hvitis/Alfa/.github/social-preview.png

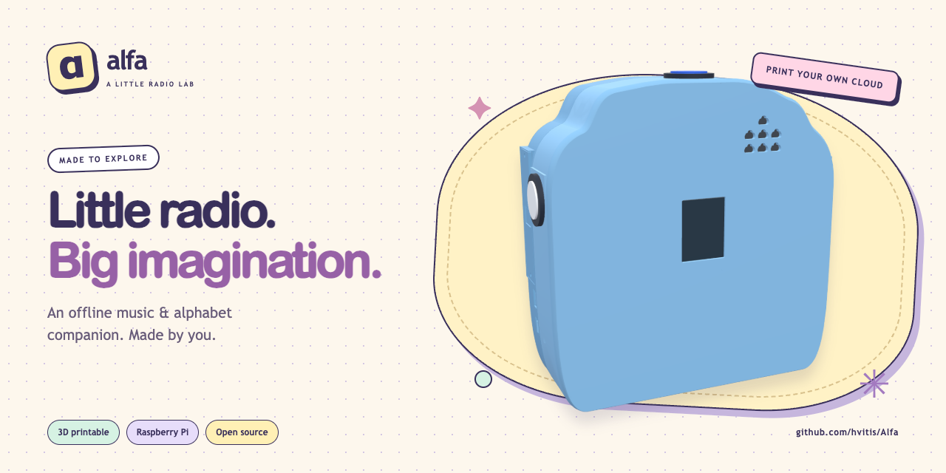
.github/social-preview.png
