hvitis/Alfa/assets/alphabet/01-Ą.png

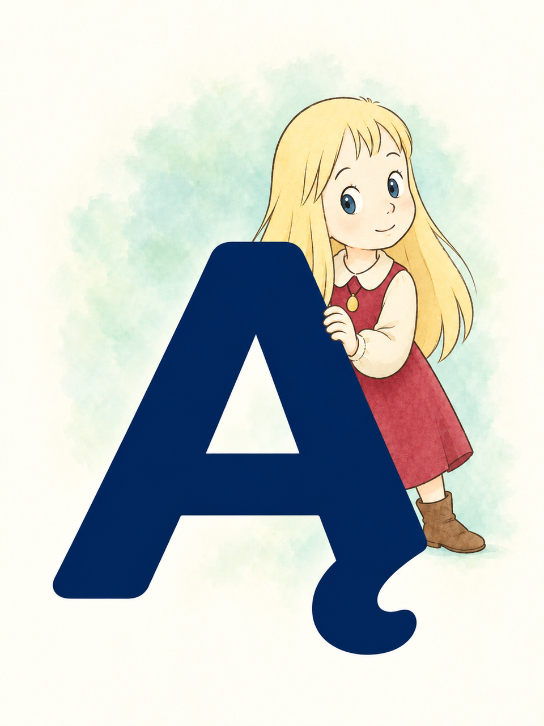
assets/alphabet/01-Ą.png
