hvitis/Alfa/assets/alphabet/04-Ć.png

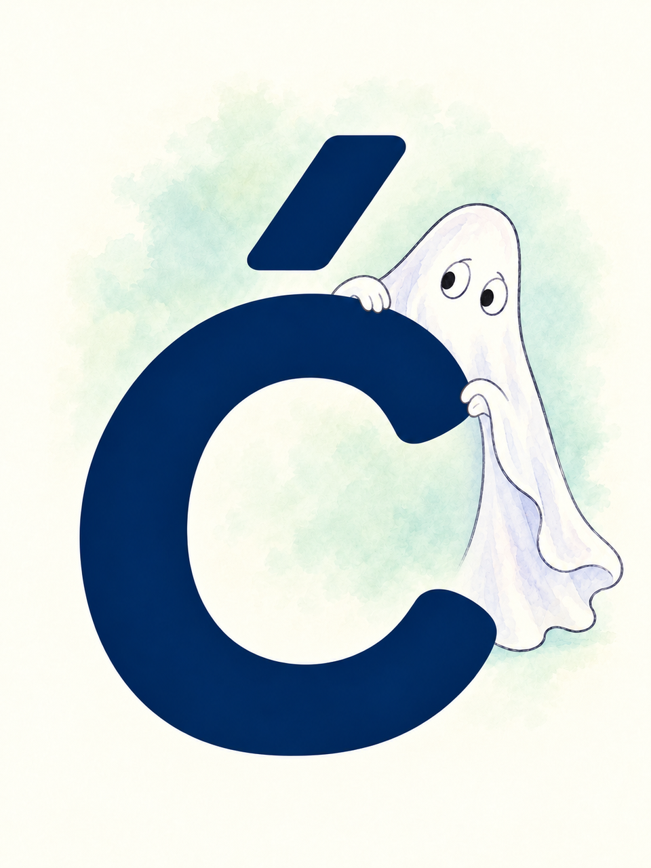
assets/alphabet/04-Ć.png
