hvitis/Alfa/assets/alphabet/07-Ę.png

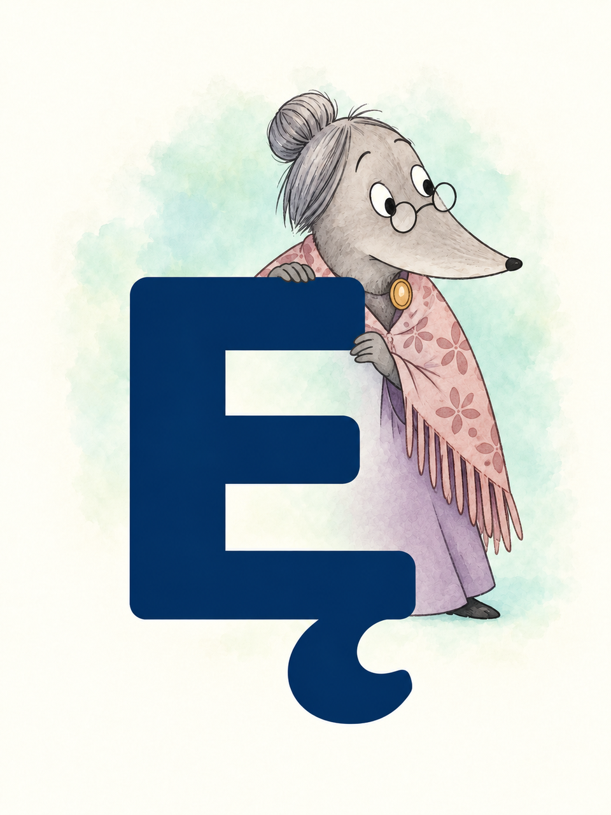
assets/alphabet/07-Ę.png
