hvitis/Alfa/assets/alphabet/11-I.png

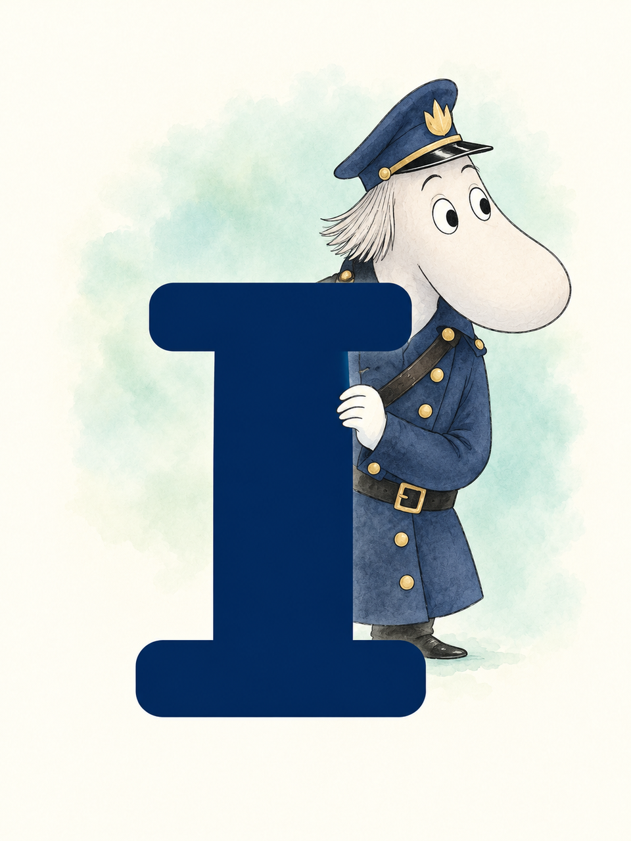
assets/alphabet/11-I.png
