hvitis/Alfa/assets/alphabet/12-J.png

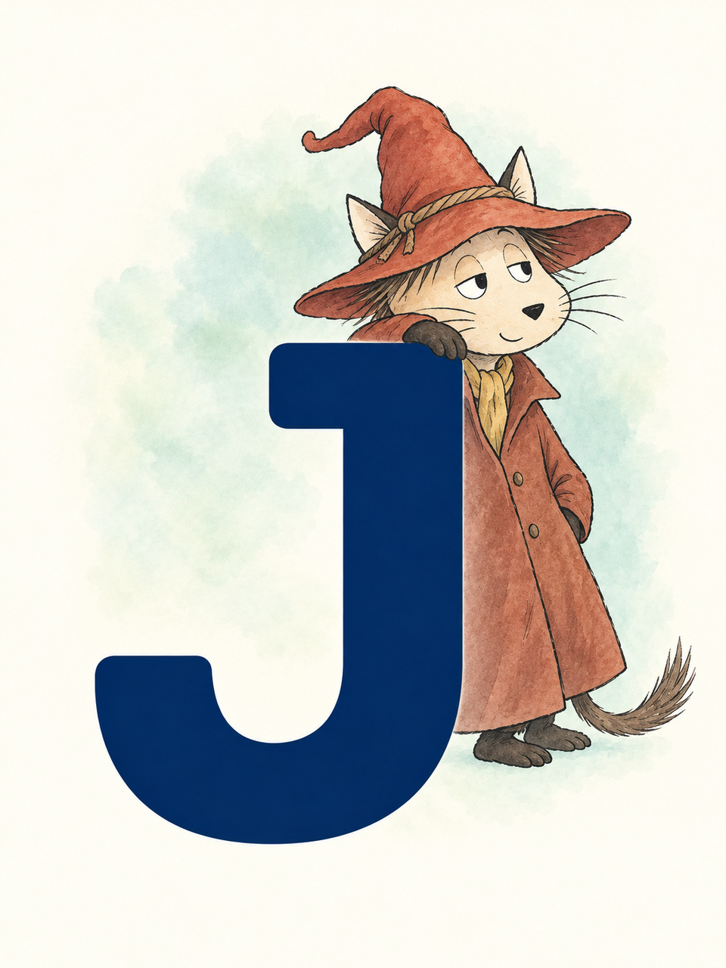
assets/alphabet/12-J.png
