hvitis/Alfa/assets/alphabet/13-K.png

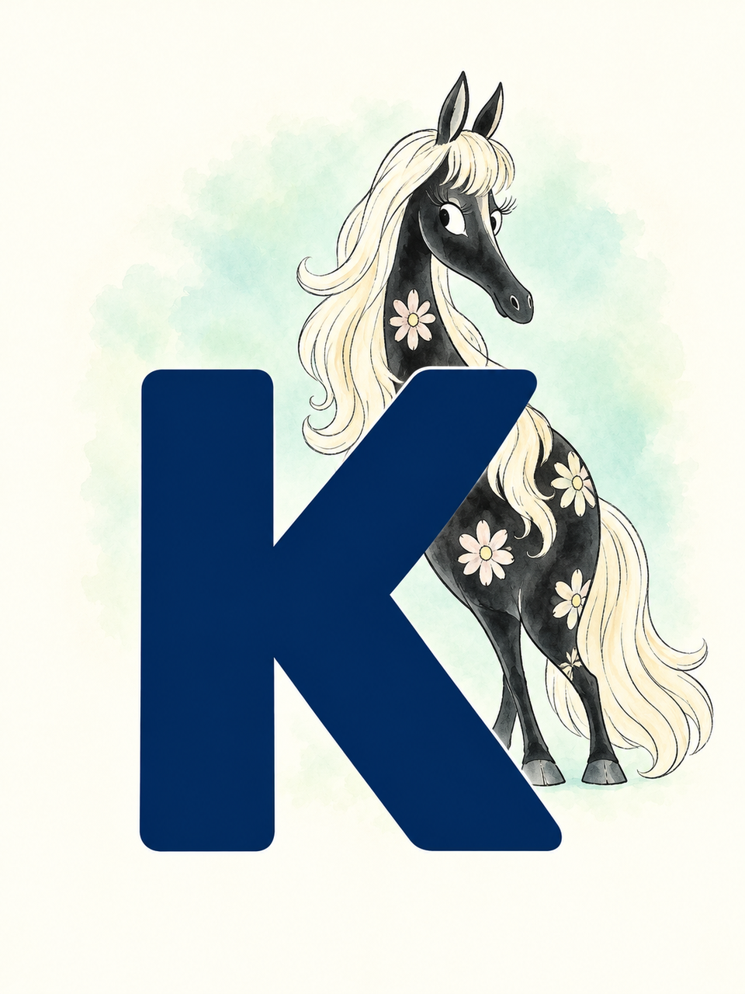
assets/alphabet/13-K.png
