hvitis/Alfa/assets/alphabet/14-L.png

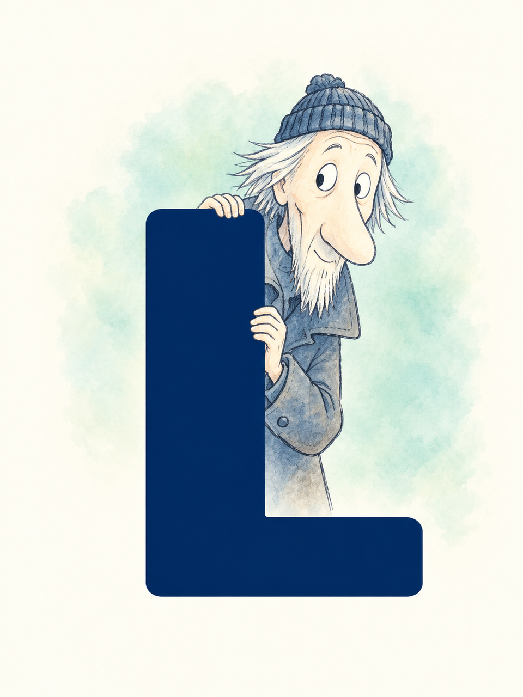
assets/alphabet/14-L.png
