hvitis/Alfa/assets/alphabet/15-Ł.png

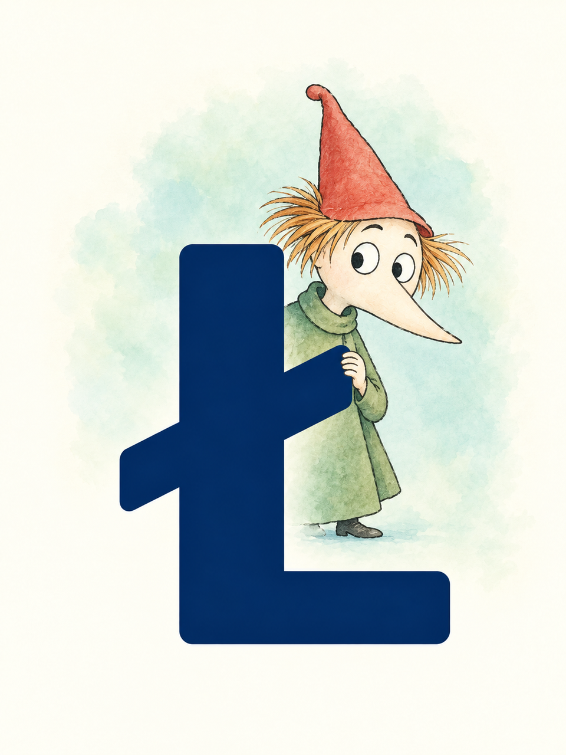
assets/alphabet/15-Ł.png
