hvitis/Alfa/assets/alphabet/17-N.png

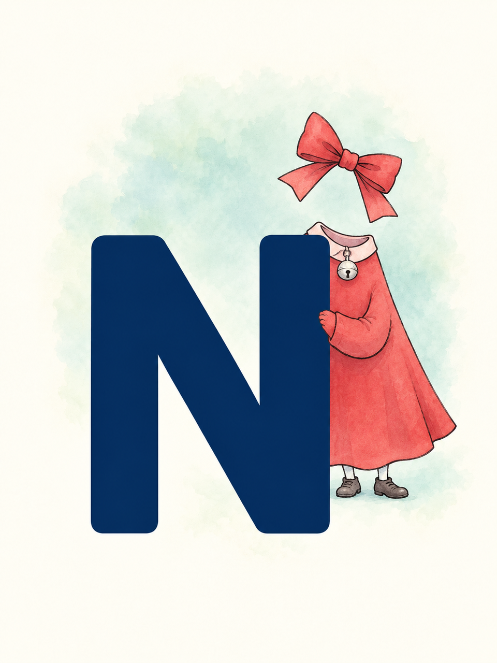
assets/alphabet/17-N.png
