hvitis/Alfa/assets/alphabet/18-Ń.png

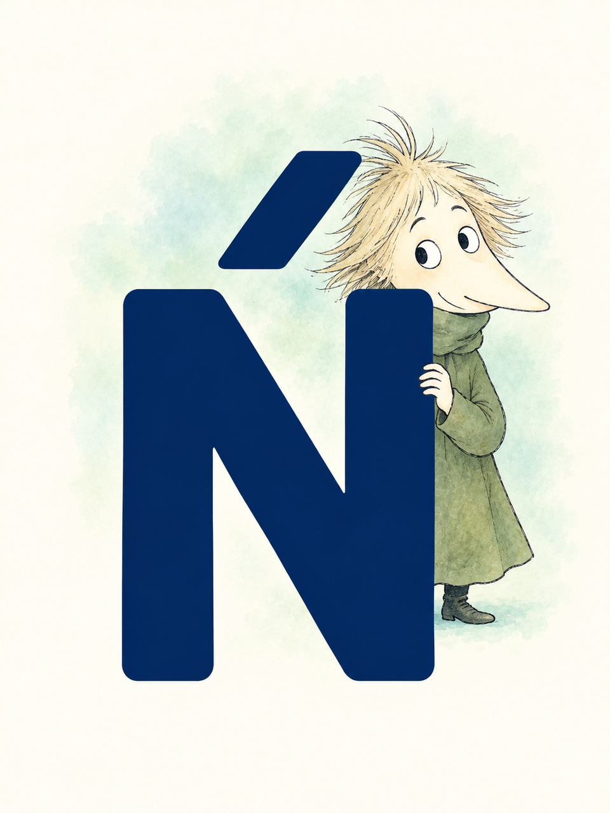
assets/alphabet/18-Ń.png
