hvitis/Alfa/assets/alphabet/19-O.png

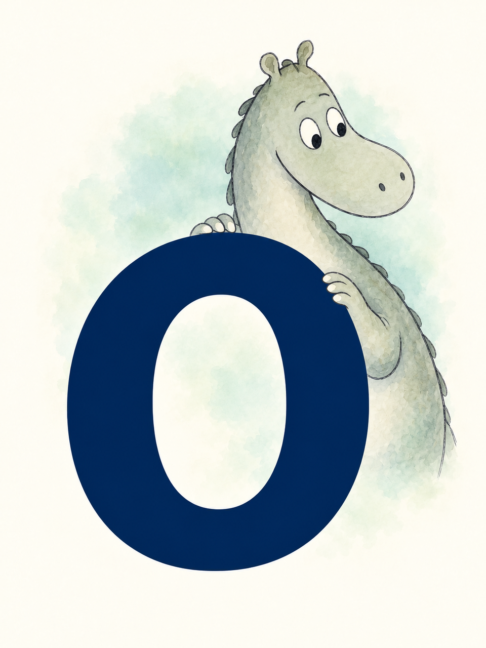
assets/alphabet/19-O.png
