hvitis/Alfa/assets/alphabet/20-Ó.png

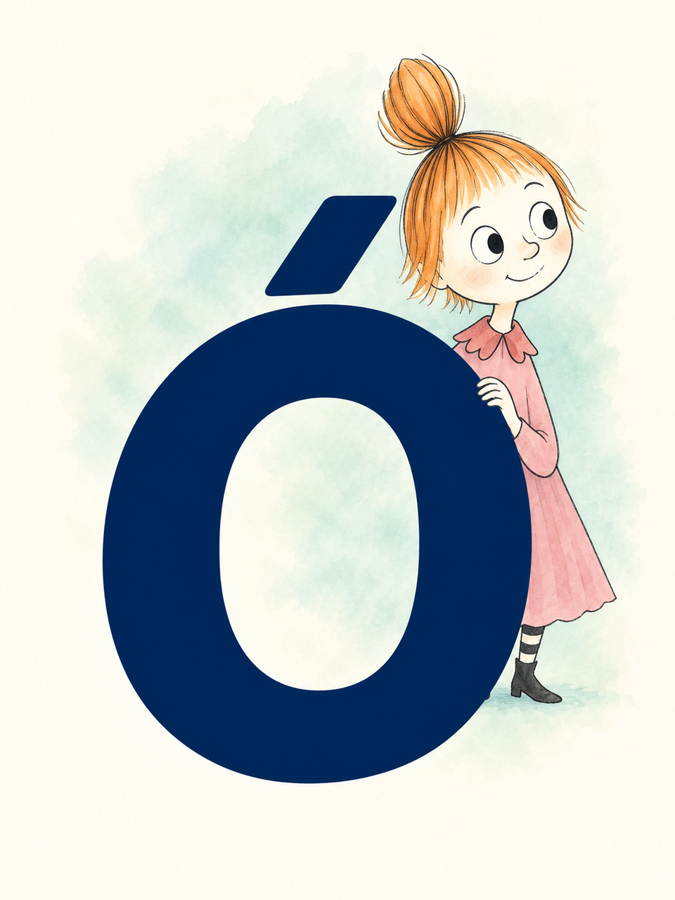
assets/alphabet/20-Ó.png
