hvitis/Alfa/assets/alphabet/21-P.png

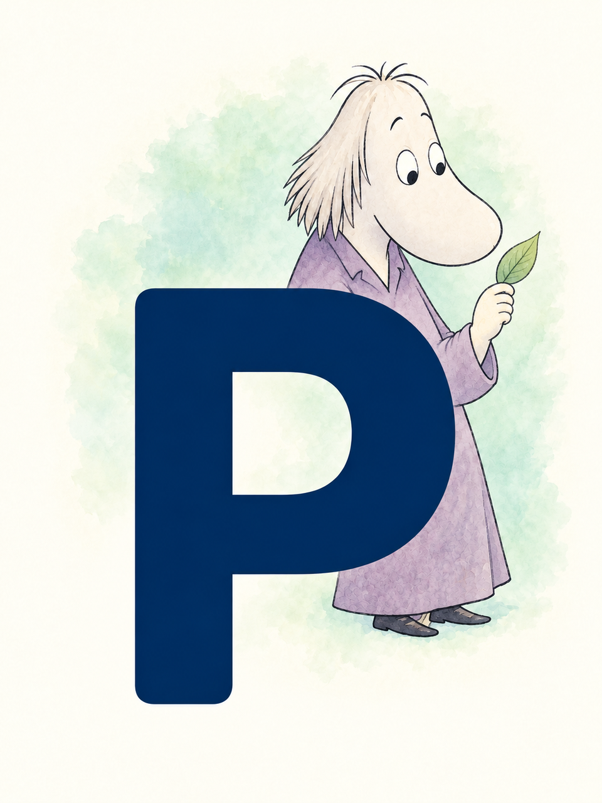
assets/alphabet/21-P.png
