hvitis/Alfa/assets/alphabet/22-R.png

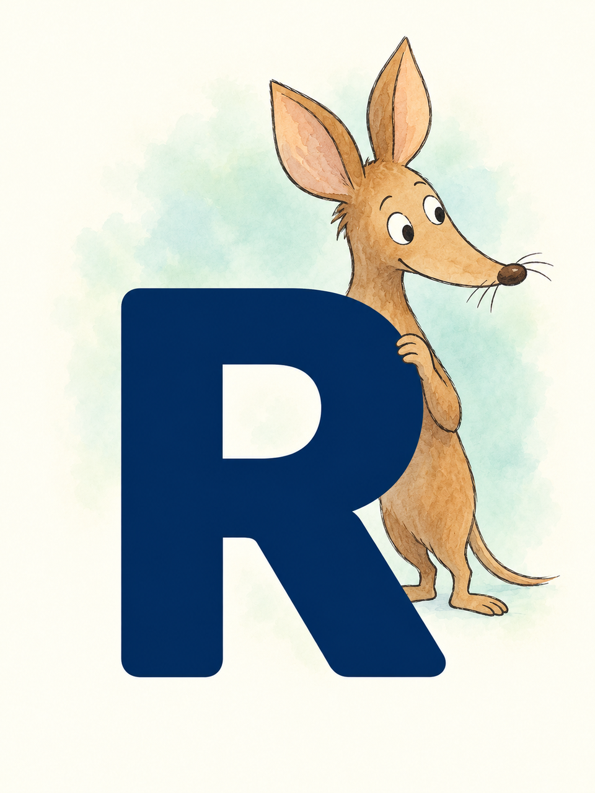
assets/alphabet/22-R.png
