hvitis/Alfa/assets/alphabet/24-Ś.png

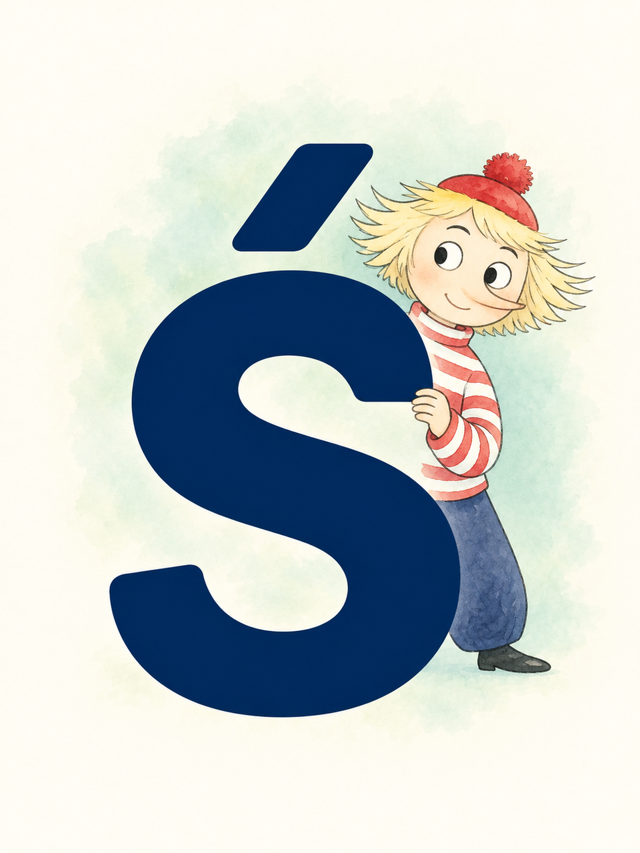
assets/alphabet/24-Ś.png
