hvitis/Alfa/assets/alphabet/27-W.png

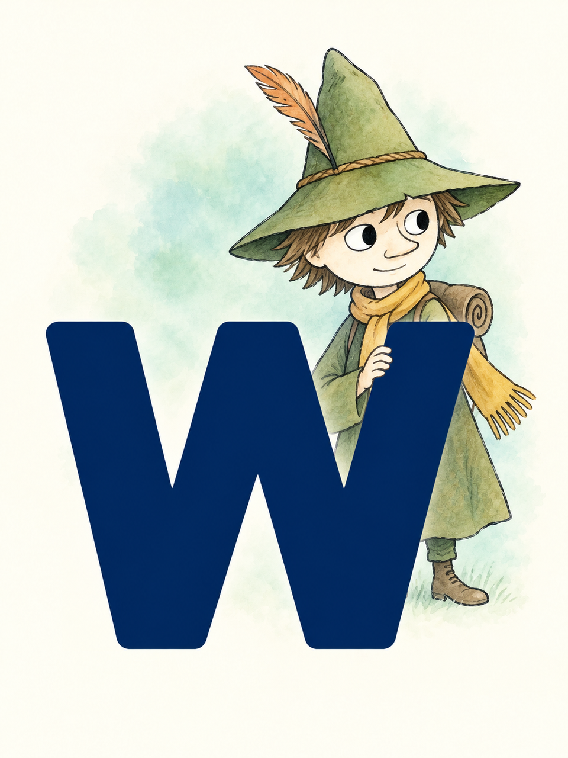
assets/alphabet/27-W.png
