hvitis/Alfa/assets/alphabet/28-Y.png

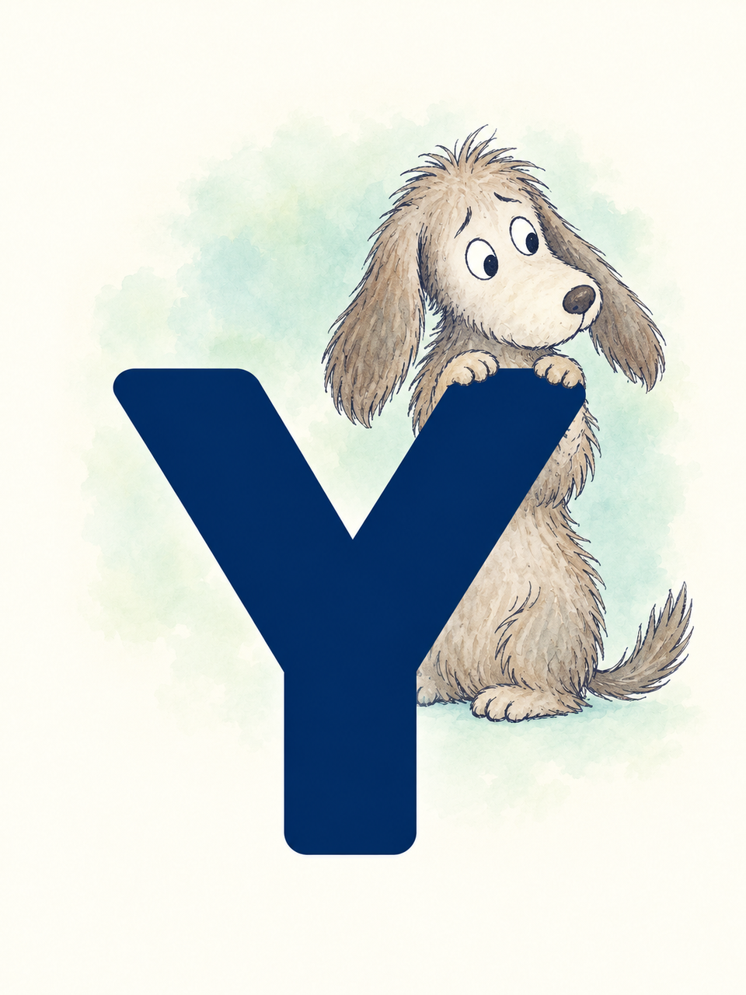
assets/alphabet/28-Y.png
