hvitis/Alfa/assets/animations/clapping-atlas.png

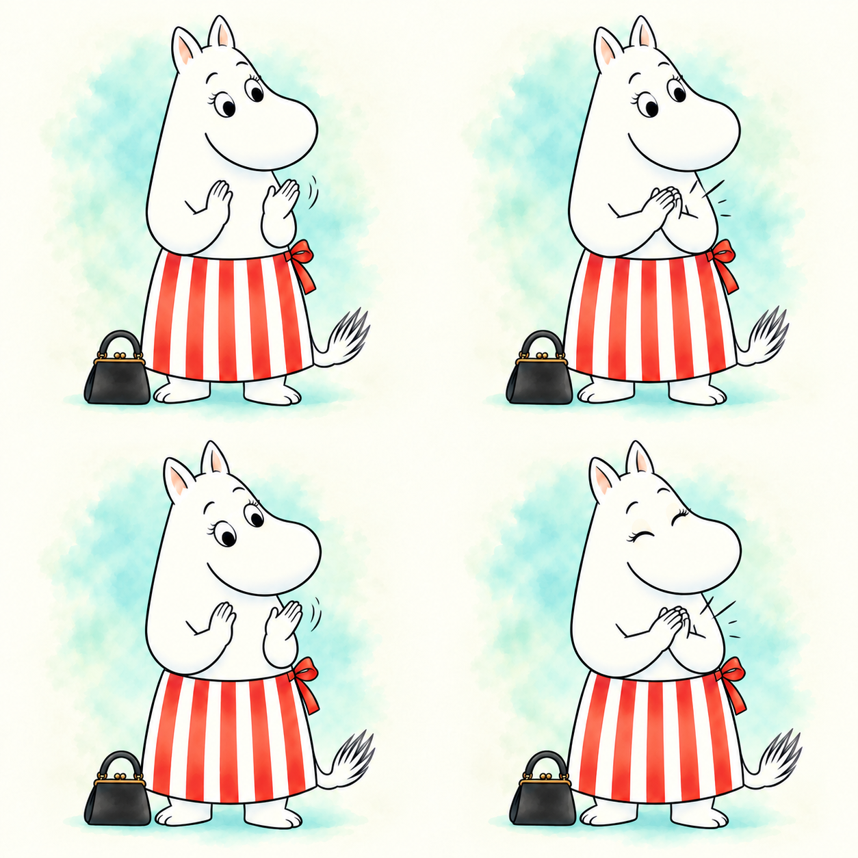
assets/animations/clapping-atlas.png
