hvitis/Alfa/assets/animations/hemulen-atlas.png

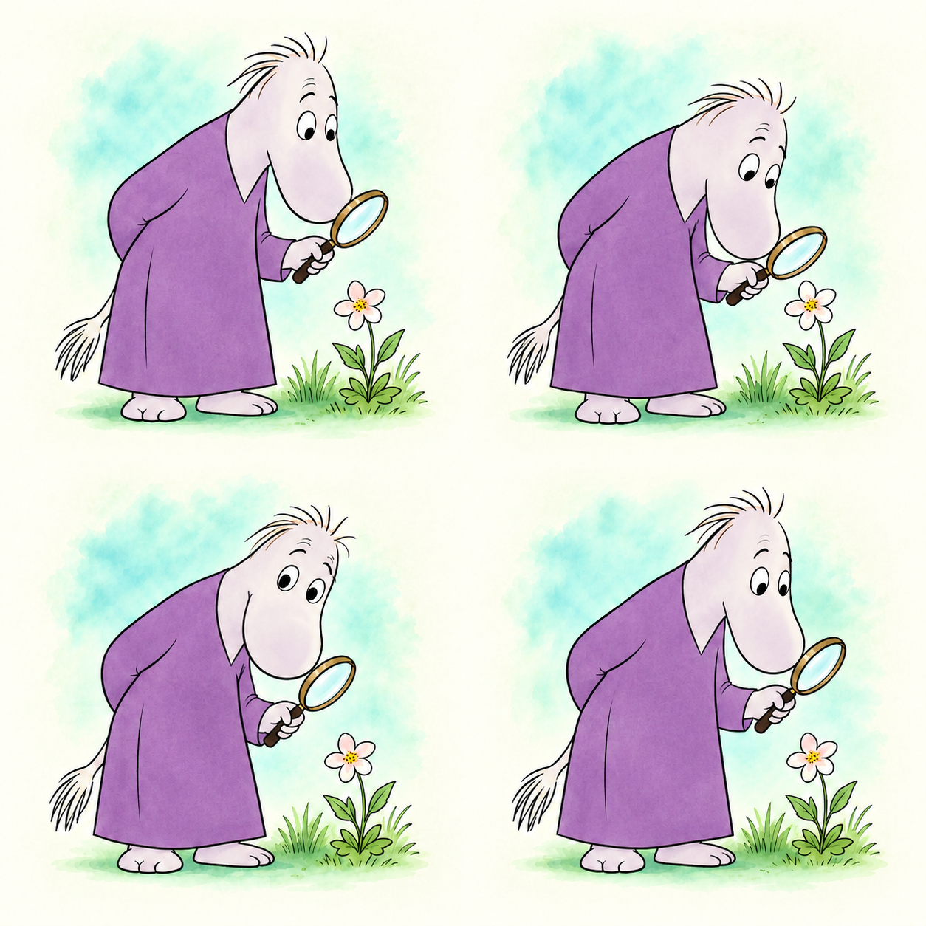
assets/animations/hemulen-atlas.png
