hvitis/Alfa/assets/animations/hemulen-base.png

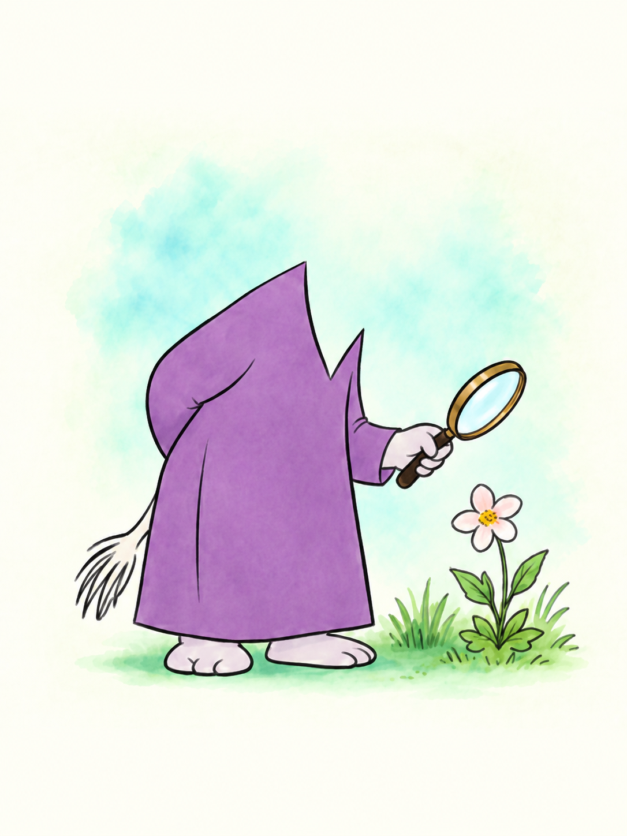
assets/animations/hemulen-base.png
