hvitis/Alfa/assets/animations/hemulen-heads.png

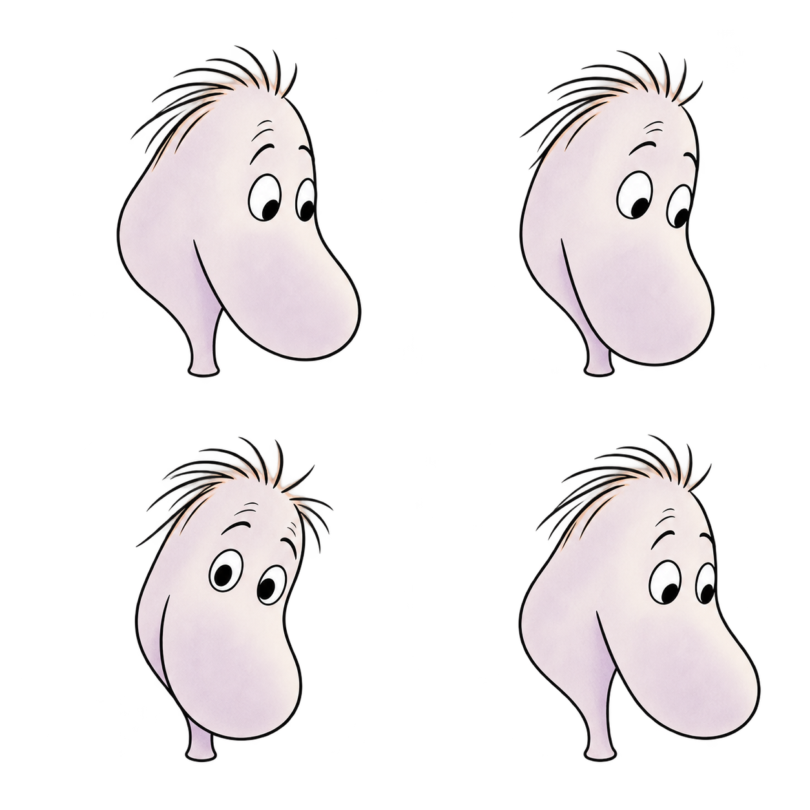
assets/animations/hemulen-heads.png
