hvitis/Alfa/assets/animations/listening-atlas.png

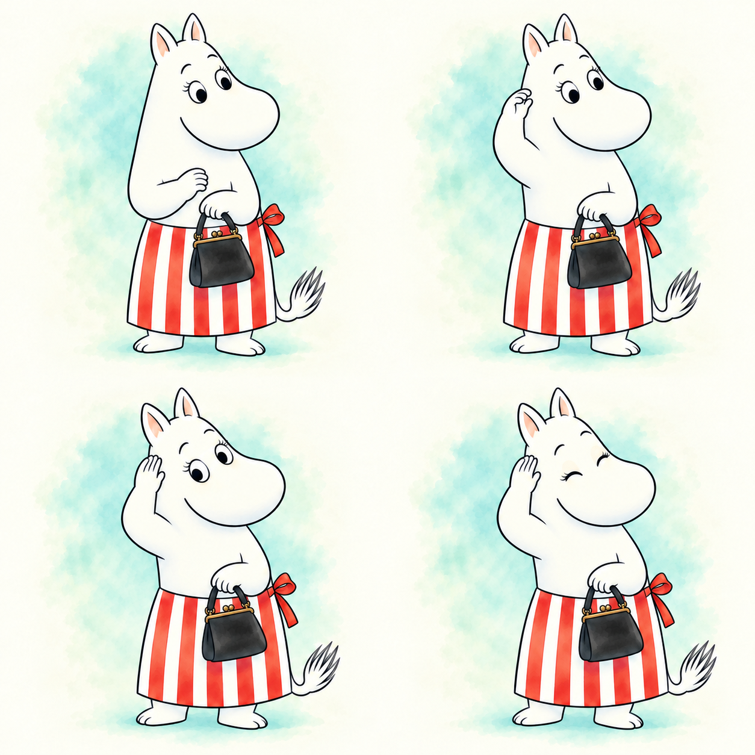
assets/animations/listening-atlas.png
