hvitis/Alfa/assets/animations/references/speaking-smile.jpg

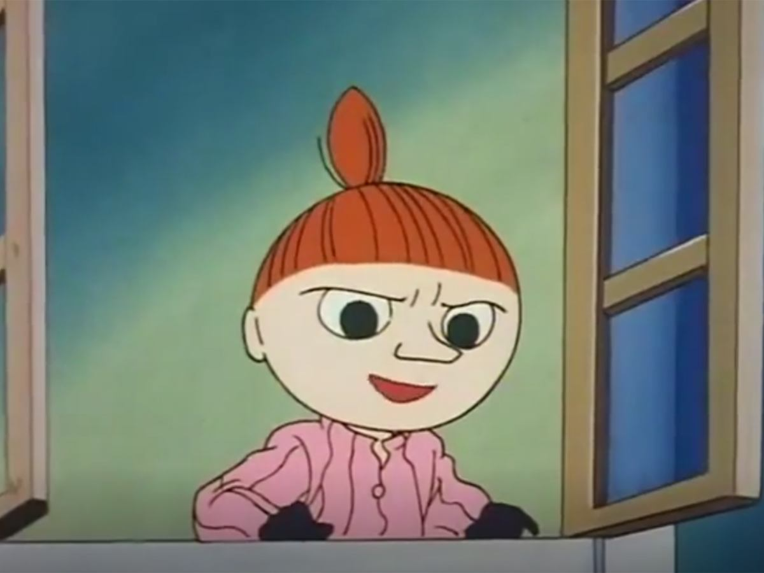
assets/animations/references/speaking-smile.jpg
