hvitis/Alfa/docs/alphabet-character-swaps.png

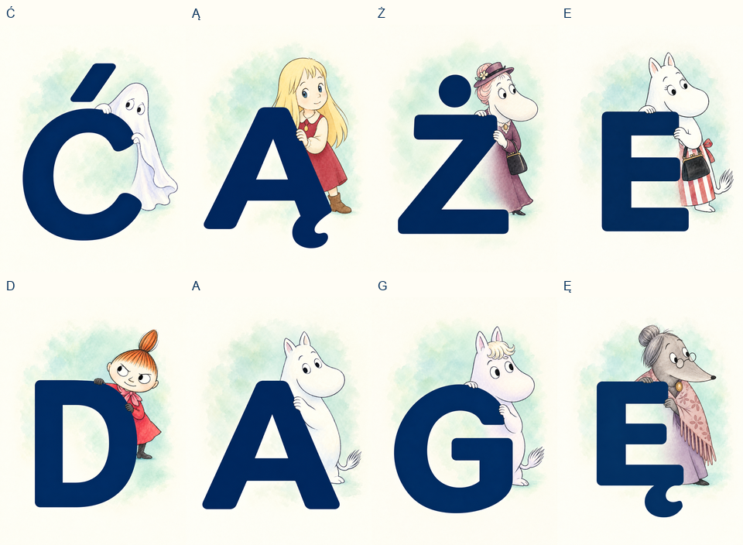
docs/alphabet-character-swaps.png
