hvitis/Alfa/docs/images/cloud-exploded.png

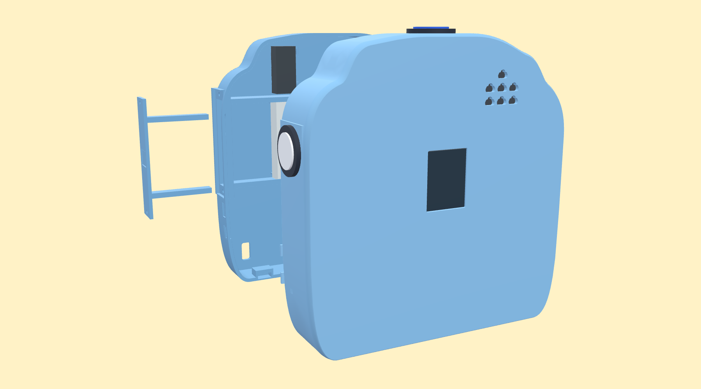
docs/images/cloud-exploded.png
