hvitis/Alfa/docs/images/cloud-rear.png

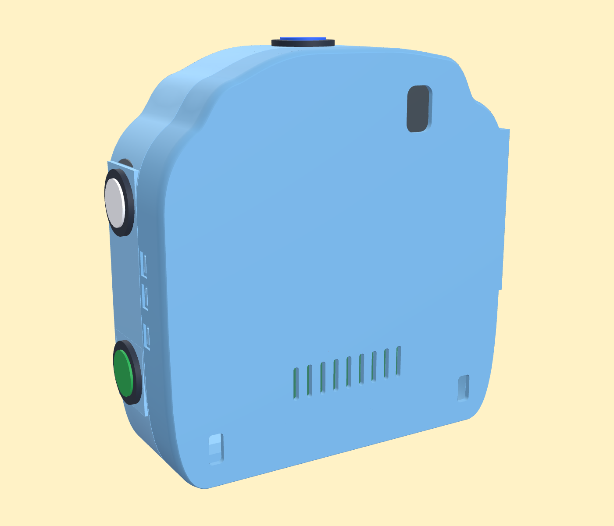
docs/images/cloud-rear.png
