hvitis/Alfa/docs/images/cloud-side.png

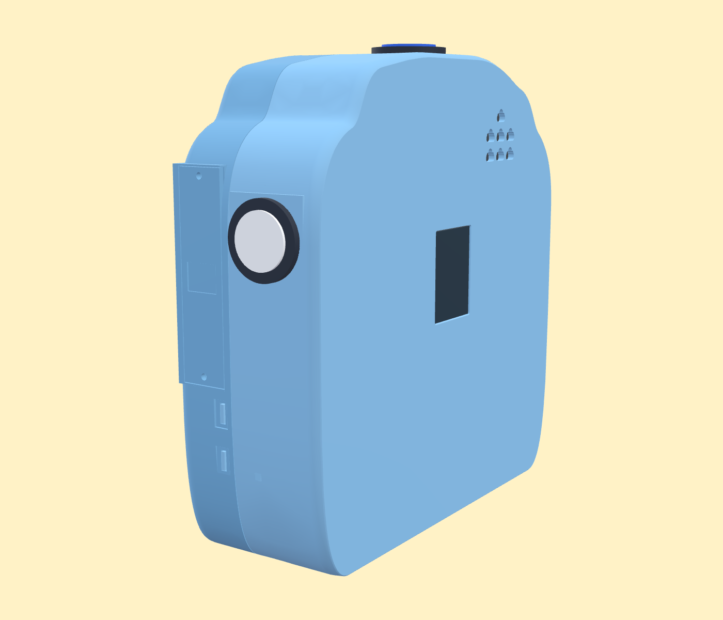
docs/images/cloud-side.png
