hvitis/Alfa/docs/letter-drawing-contact-sheet.png

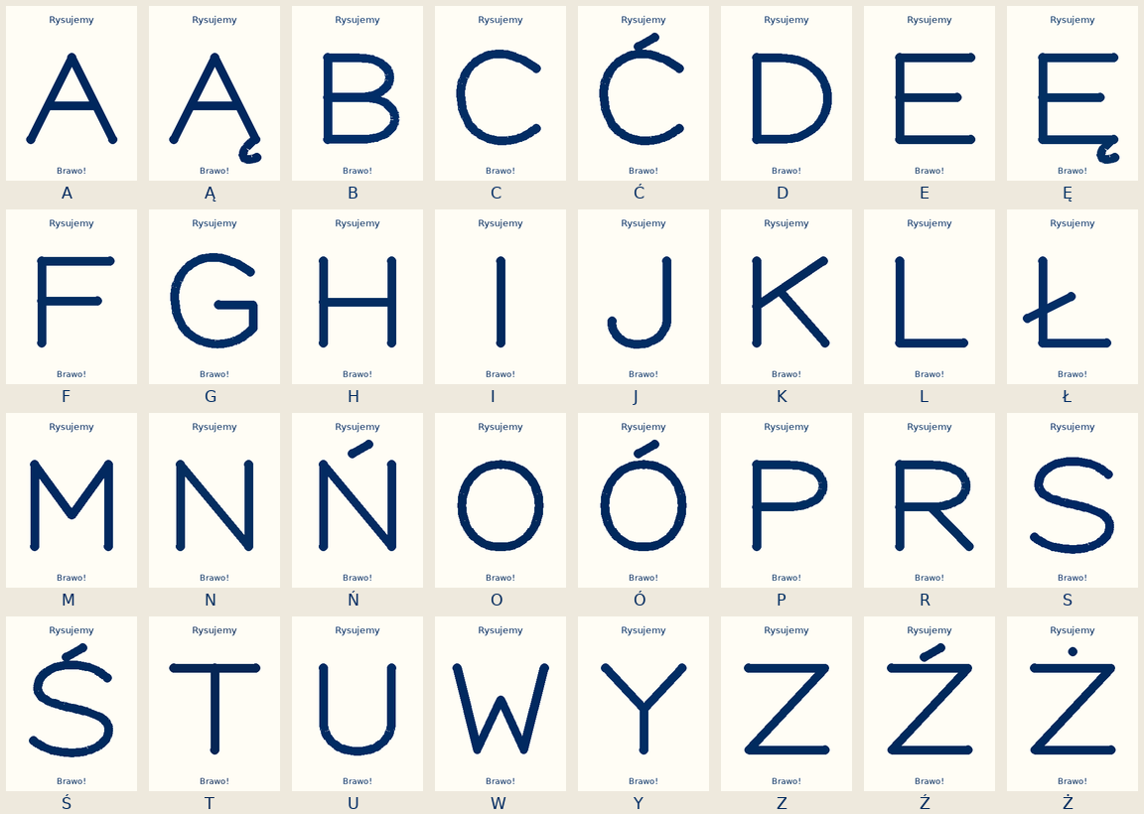
docs/letter-drawing-contact-sheet.png
