hvitis/Alfa/media/alphabet/000-00-A.png

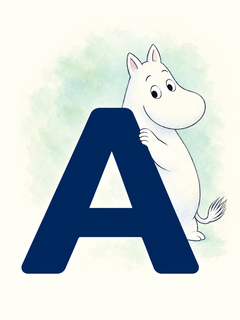
media/alphabet/000-00-A.png
