hvitis/Alfa/media/alphabet/002-02-B.png

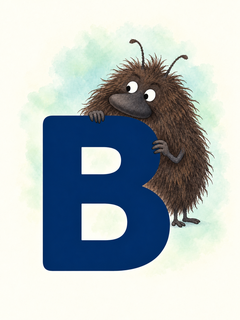
media/alphabet/002-02-B.png
