hvitis/Alfa/media/alphabet/003-03-C.png

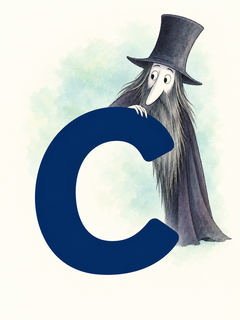
media/alphabet/003-03-C.png
