hvitis/Alfa/media/alphabet/008-08-F.png

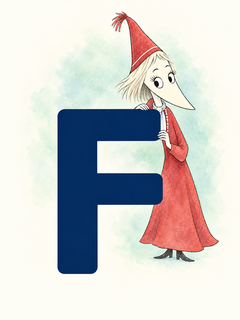
media/alphabet/008-08-F.png
