hvitis/Alfa/media/alphabet/009-09-G.png

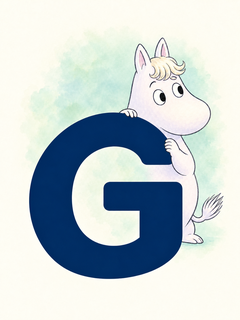
media/alphabet/009-09-G.png
