hvitis/Alfa/media/alphabet/010-10-H.png

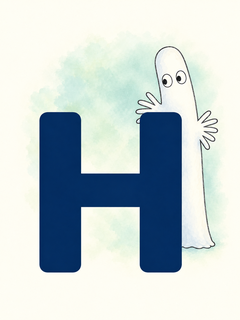
media/alphabet/010-10-H.png
