hvitis/Alfa/media/alphabet/023-23-S.png

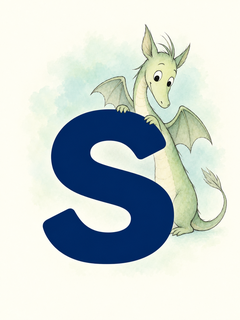
media/alphabet/023-23-S.png
