hvitis/Alfa/media/alphabet/026-26-U.png

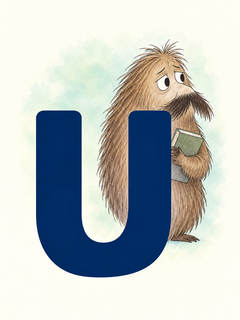
media/alphabet/026-26-U.png
