hvitis/Alfa/media/alphabet/029-29-Z.png

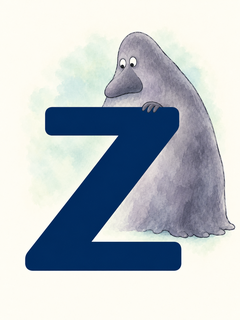
media/alphabet/029-29-Z.png
