hvitis/Alfa/media/alphabet/030-30-Ź.png

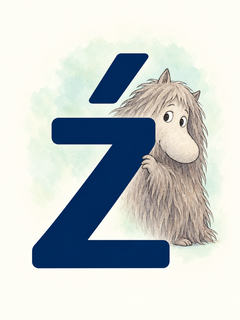
media/alphabet/030-30-Ź.png
