hvitis/Alfa/media/alphabet/031-31-Ż.png

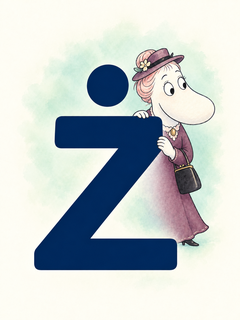
media/alphabet/031-31-Ż.png
