hvitis/Alfa/media/animations/clapping/frame-00.png

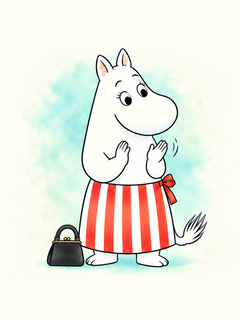
media/animations/clapping/frame-00.png
