hvitis/Alfa/media/animations/clapping/frame-01.png

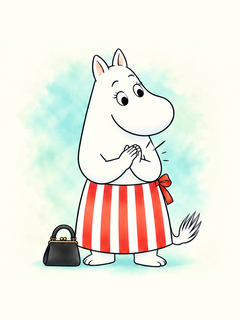
media/animations/clapping/frame-01.png
