hvitis/Alfa/media/animations/clapping/frame-03.png

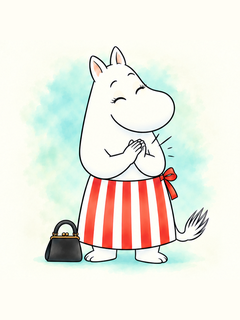
media/animations/clapping/frame-03.png
