hvitis/Alfa/media/animations/hemulen/frame-00.png

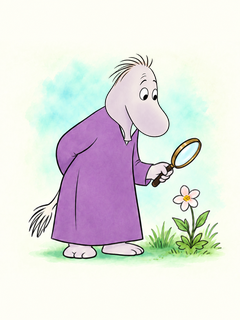
media/animations/hemulen/frame-00.png
