hvitis/Alfa/media/animations/hemulen/frame-11.png

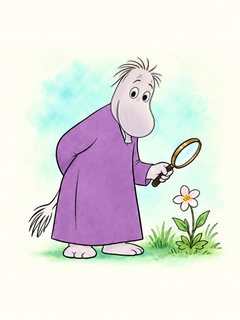
media/animations/hemulen/frame-11.png
