hvitis/Alfa/media/images/002-illustration_2.png

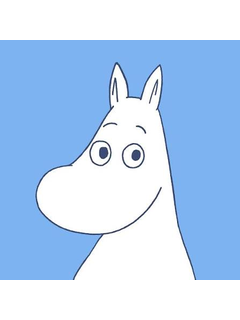
media/images/002-illustration_2.png
