hvitis/Alfa/scratch/stl-preview.png

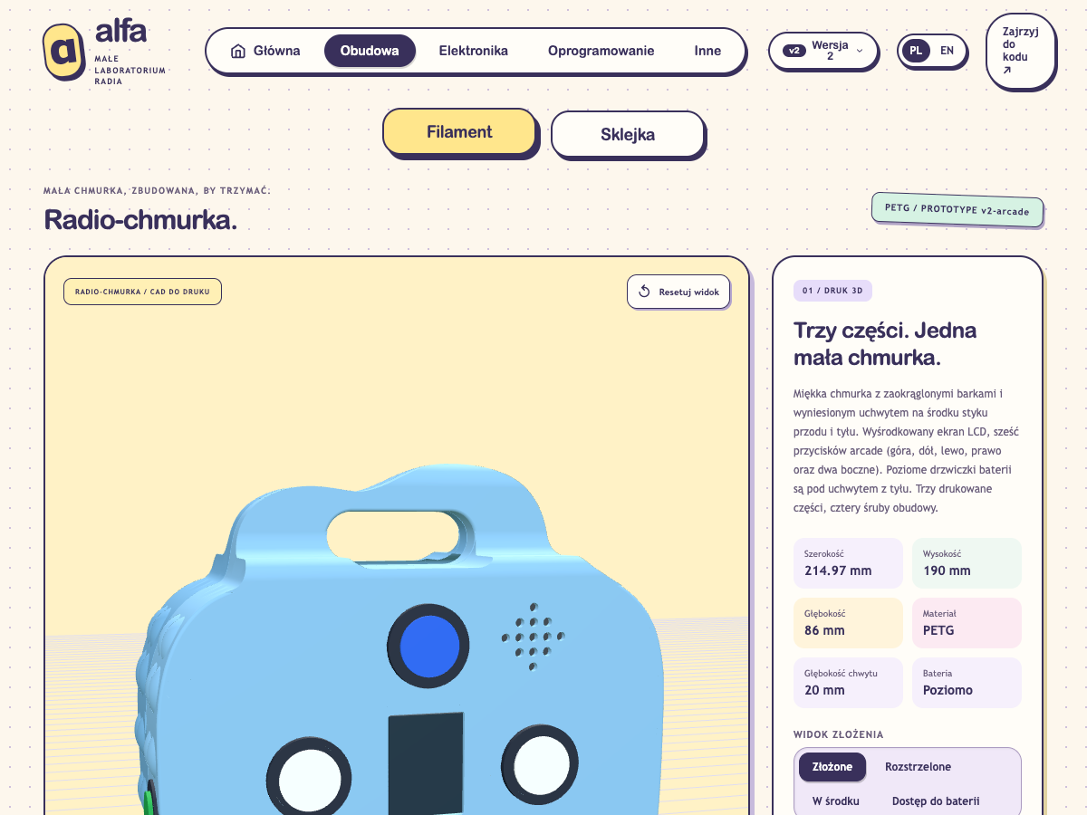
scratch/stl-preview.png
