hvitis/Alfa/scratch/stl-section.png

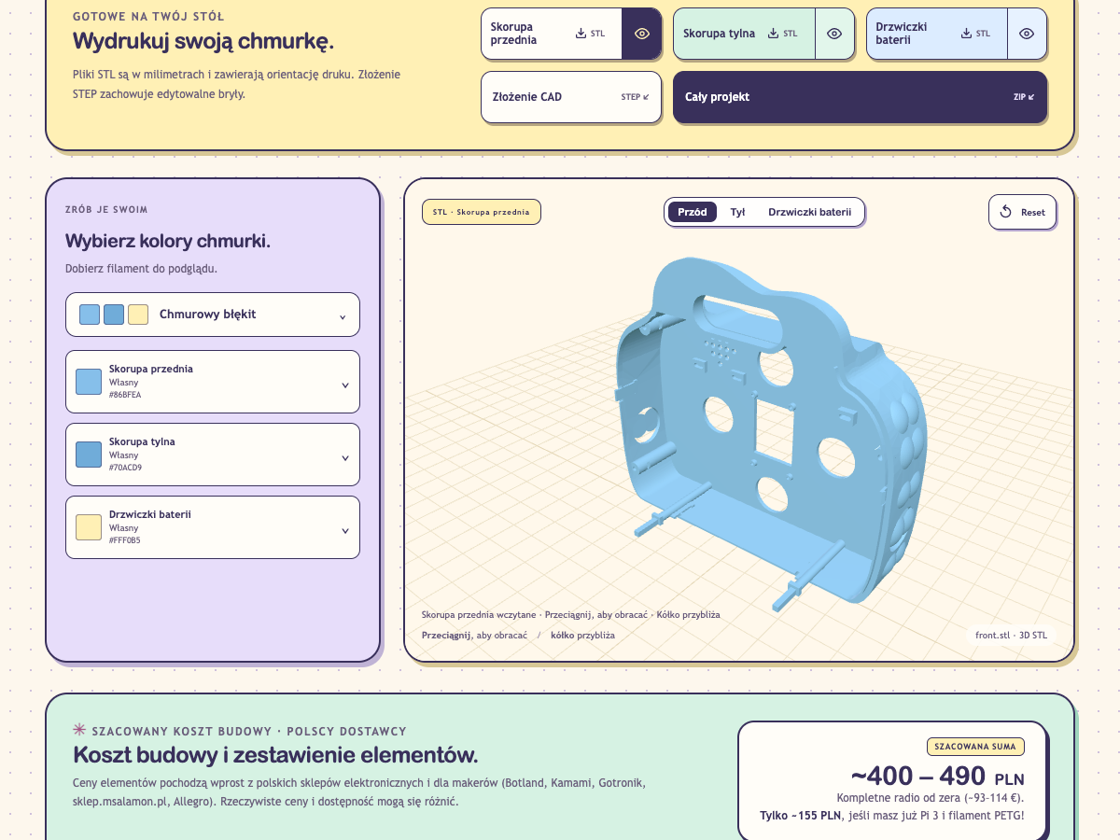
scratch/stl-section.png
