hvitis/Alfa/web/assets/cloud-render.png

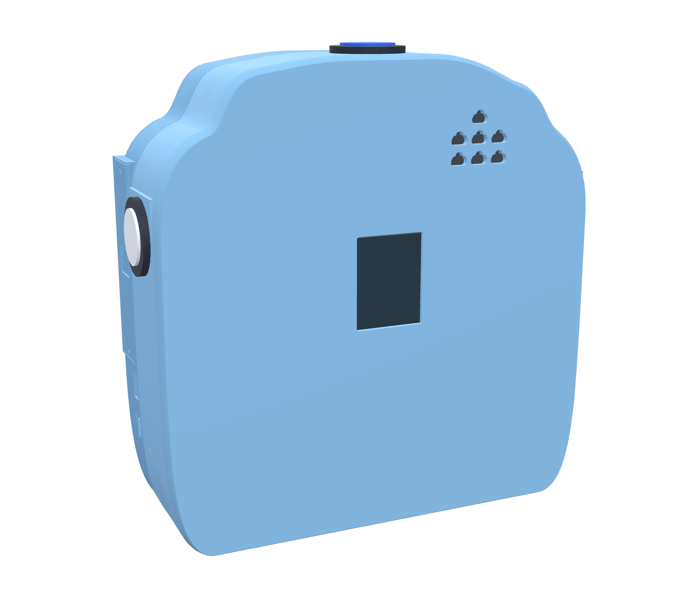
web/assets/cloud-render.png
