hvitis/Alfa/web/assets/og-pcb.png

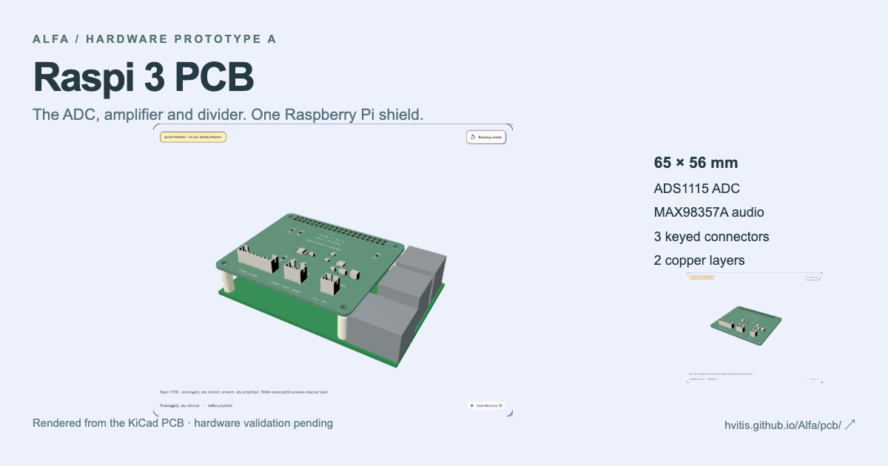
web/assets/og-pcb.png
