hvitis/Alfa/web/assets/pdf-preview.png

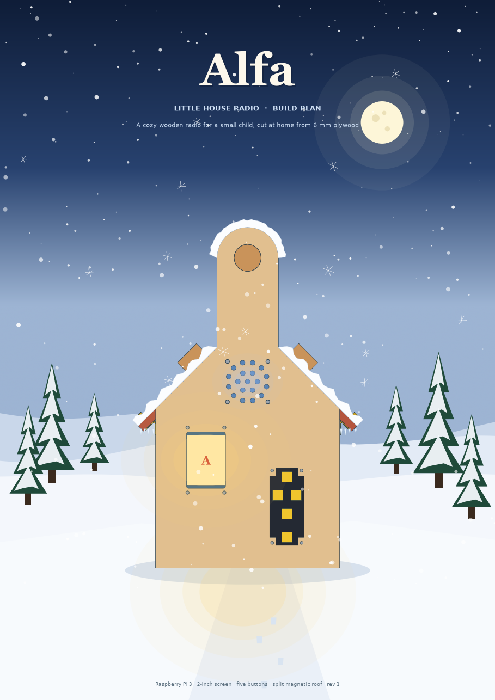
web/assets/pdf-preview.png
