hvitis/Alfa/web/hardware-visualisation/src/data/radio-images/cloud.png

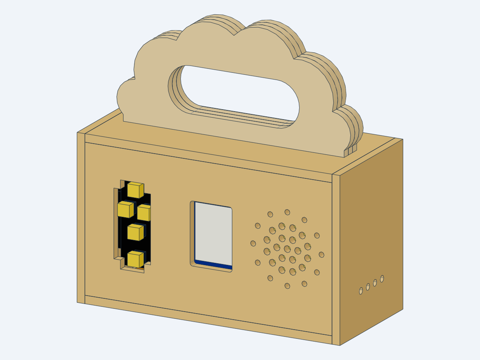
web/hardware-visualisation/src/data/radio-images/cloud.png
