hvitis/Alfa/web/hardware-visualisation/src/data/radio-images/house.png

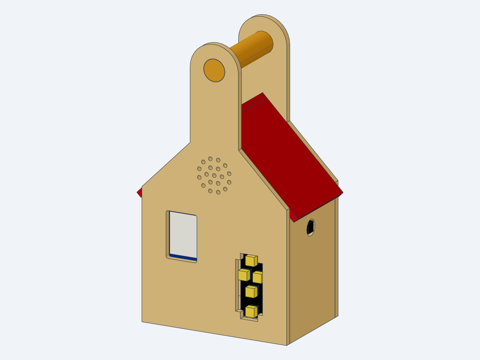
web/hardware-visualisation/src/data/radio-images/house.png
