hvitis/Alfa/web/hardware-visualisation/src/data/radio-images/lunchbox.png

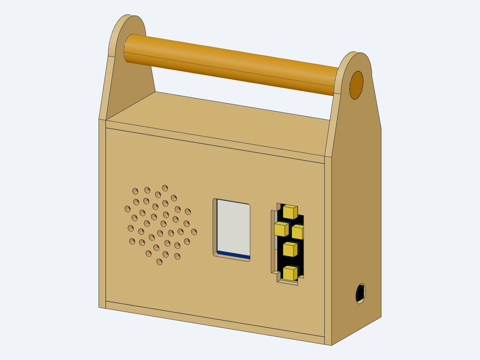
web/hardware-visualisation/src/data/radio-images/lunchbox.png
