hvitis/Alfa/web/hardware-visualisation/src/data/radio-images/page_cover.png

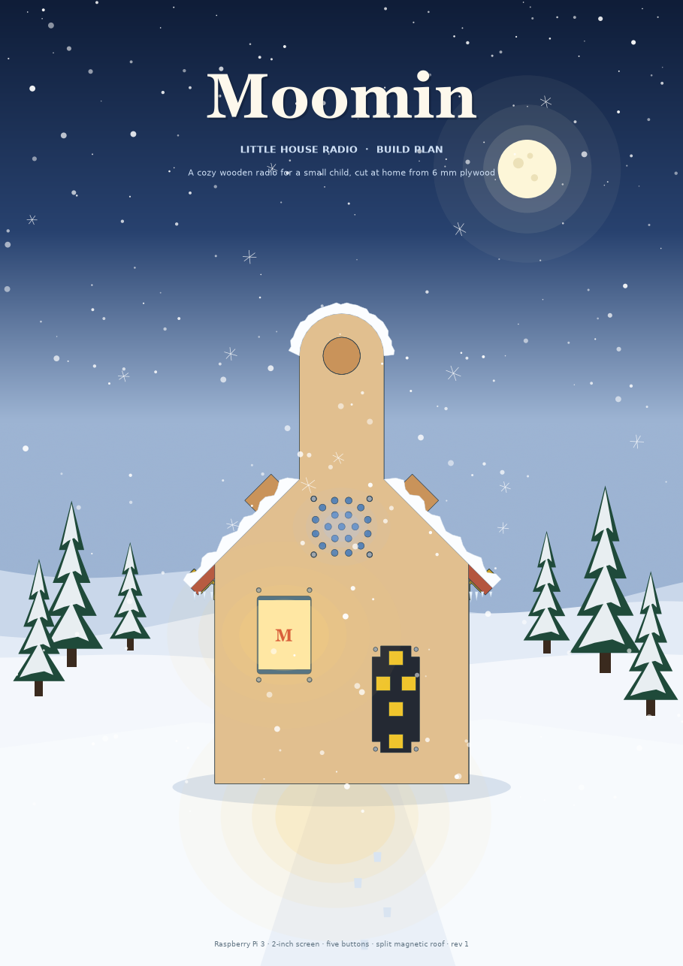
web/hardware-visualisation/src/data/radio-images/page_cover.png
