hvitis/Alfa/web/hardware-visualisation/src/data/radio-images/sheet_cloud.png

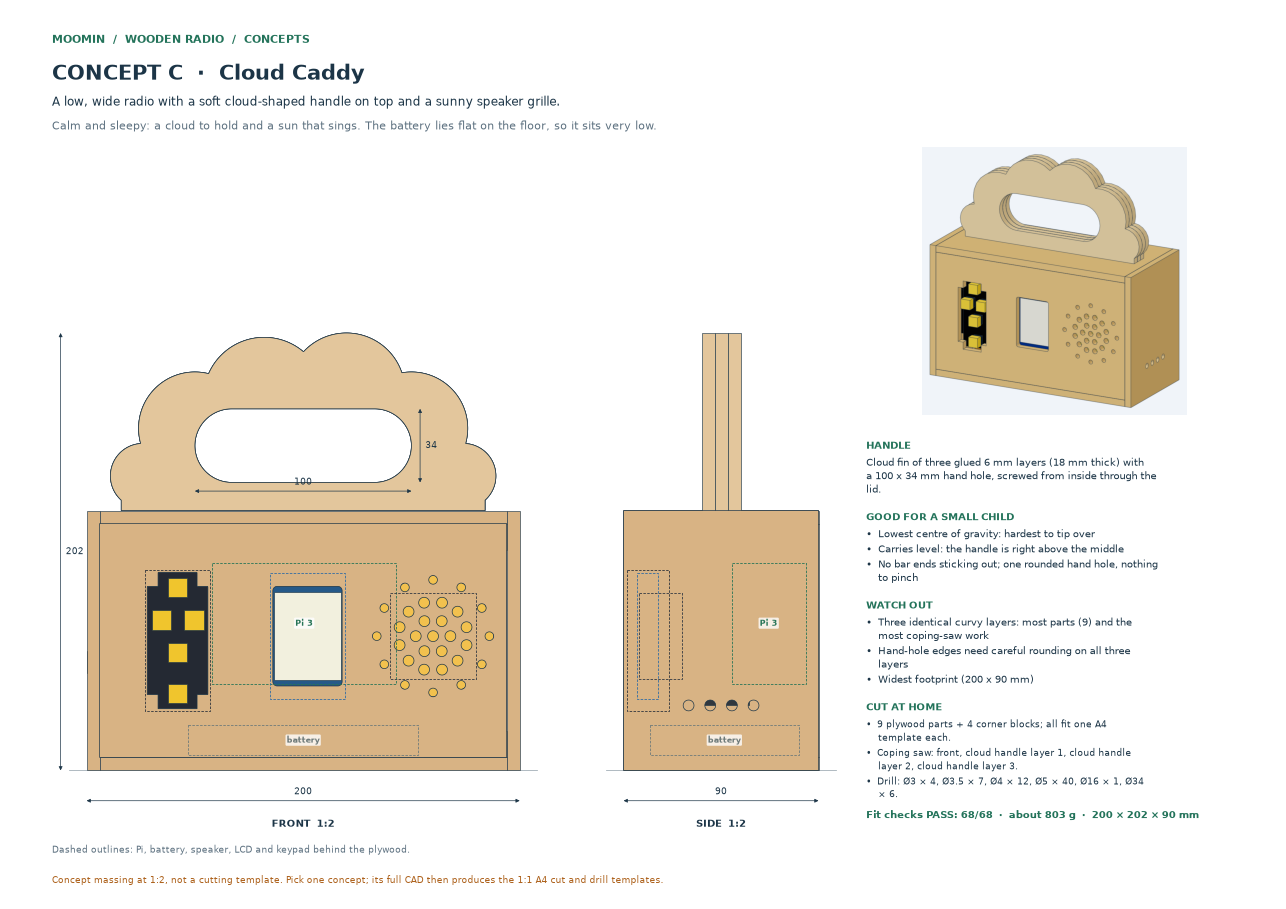
web/hardware-visualisation/src/data/radio-images/sheet_cloud.png
