hvitis/Alfa/web/hardware-visualisation/src/data/radio-images/sheet_house.png

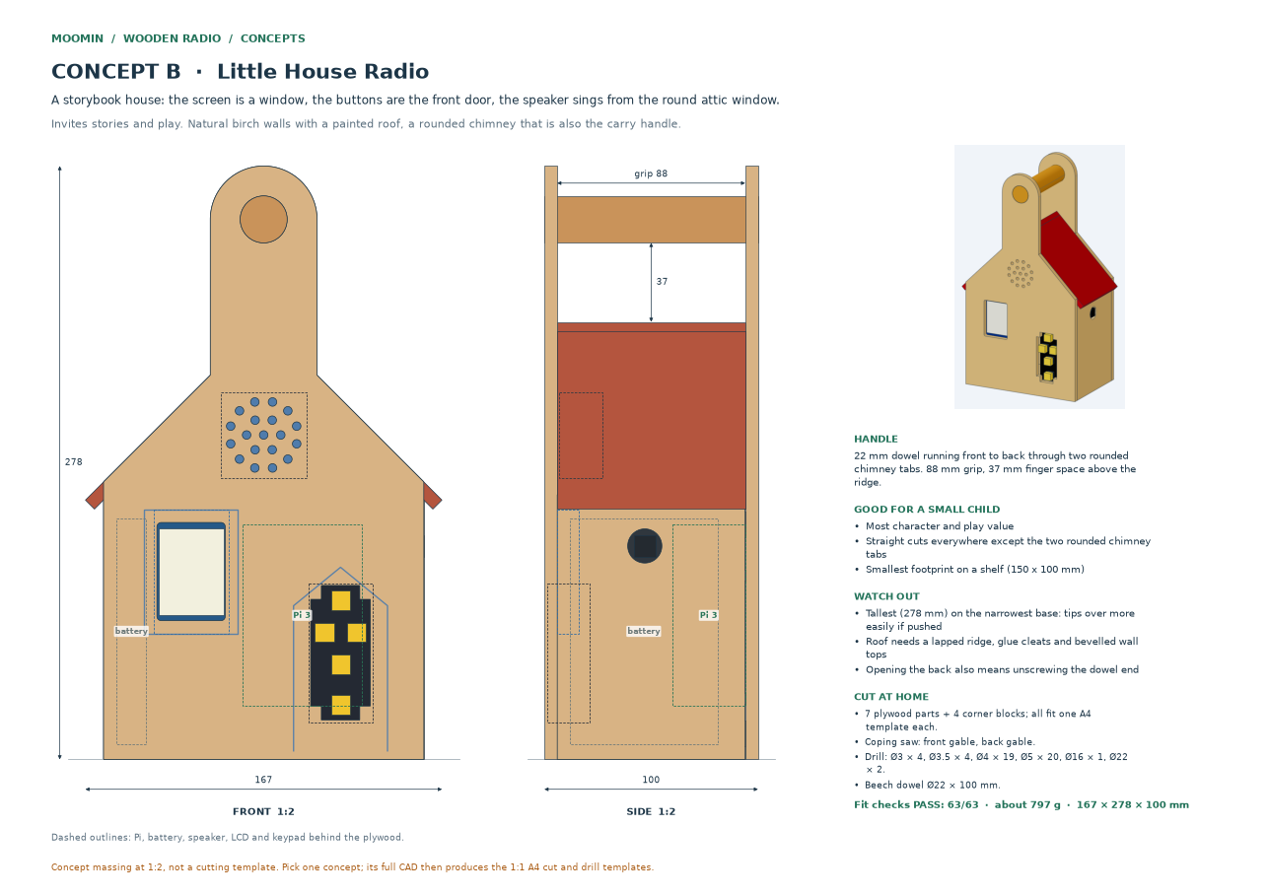
web/hardware-visualisation/src/data/radio-images/sheet_house.png
