hvitis/Alfa/web/hardware-visualisation/src/data/radio-images/sheet_lunchbox.png

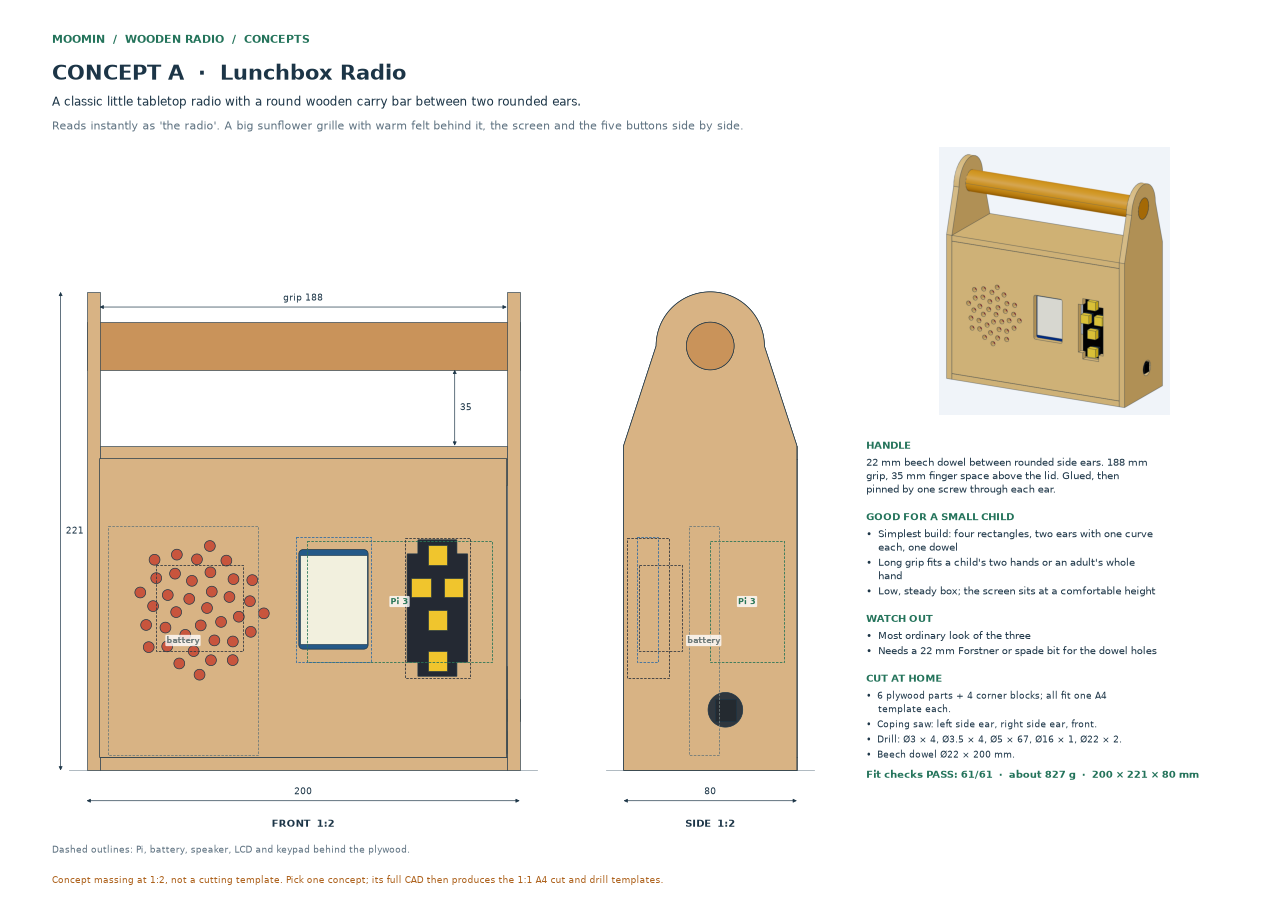
web/hardware-visualisation/src/data/radio-images/sheet_lunchbox.png
