hvitis/Alfa/web/hardware-visualisation/src/data/radio-images/sheet_overview.png

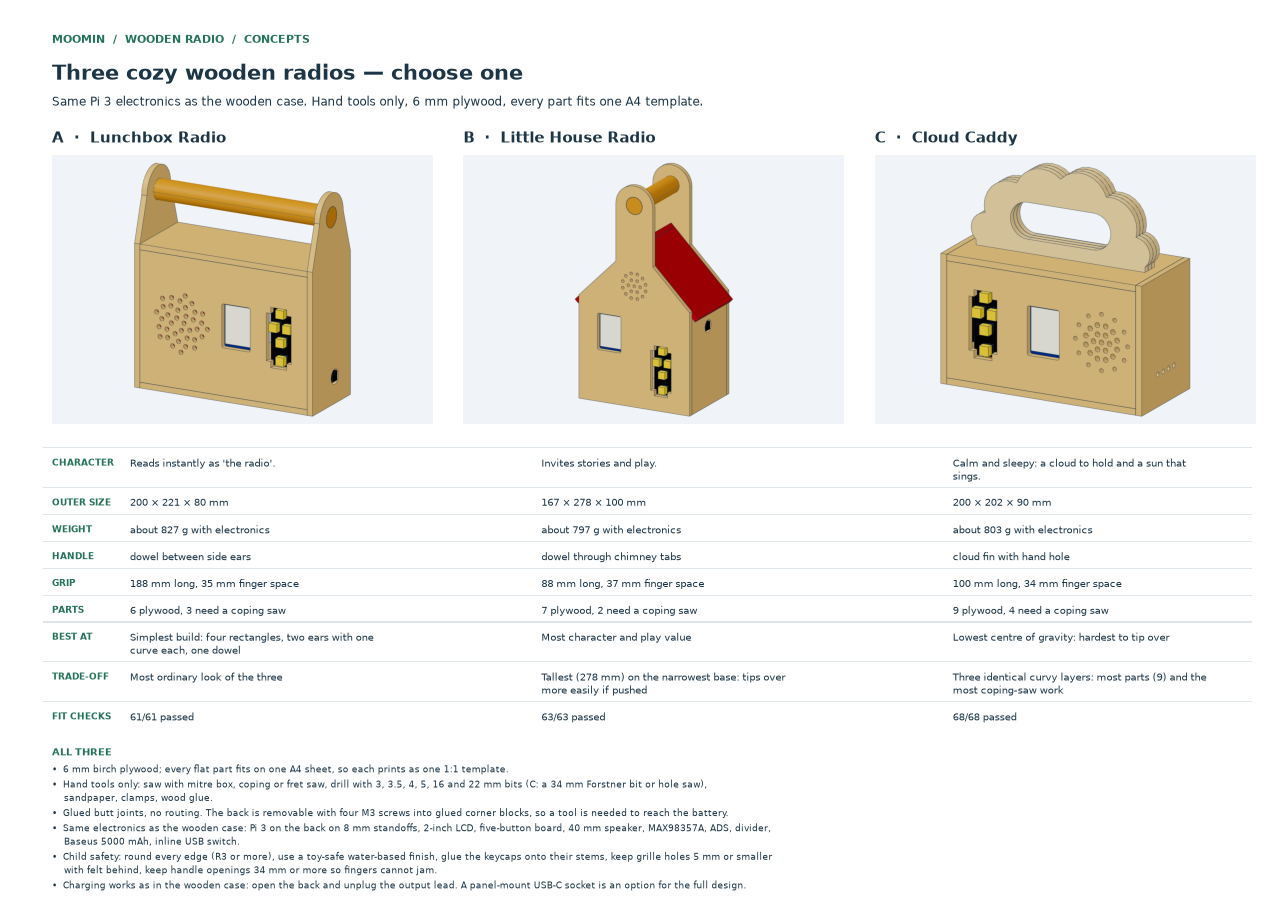
web/hardware-visualisation/src/data/radio-images/sheet_overview.png
