hvitis/Alfa/design/pi3-shield/generated/connections.csv

Reference | Pin | Pin name | Net
J1 | 1 | 3V3 | +3V3
J1 | 2 | 5V | +5V
J1 | 3 | GPIO2/SDA | I2C_SDA
J1 | 4 | 5V | +5V
J1 | 5 | GPIO3/SCL | I2C_SCL
J1 | 6 | GND | GND
J1 | 7 | GPIO4 | NC
J1 | 8 | GPIO14 | NC
J1 | 9 | GND | GND
J1 | 10 | GPIO15 | NC
J1 | 11 | GPIO17 | NC
J1 | 12 | GPIO18/BCLK | I2S_BCLK
J1 | 13 | GPIO27/RST | LCD_RST
J1 | 14 | GND | GND
J1 | 15 | GPIO22 | NC
J1 | 16 | GPIO23/ENABLE | AMP_ENABLE
J1 | 17 | 3V3 | +3V3
J1 | 18 | GPIO24/BL | LCD_BL
J1 | 19 | GPIO10/MOSI | LCD_MOSI
J1 | 20 | GND | GND
J1 | 21 | GPIO9 | NC
J1 | 22 | GPIO25/DC | LCD_DC
J1 | 23 | GPIO11/SCK | LCD_SCK
J1 | 24 | GPIO8/CE0 | LCD_CS
J1 | 25 | GND | GND
J1 | 26 | GPIO7 | NC
J1 | 27 | ID_SD/RESERVED | NC
J1 | 28 | ID_SC/RESERVED | NC
J1 | 29 | GPIO5 | NC
J1 | 30 | GND | GND
J1 | 31 | GPIO6 | NC
J1 | 32 | GPIO12 | NC
J1 | 33 | GPIO13 | NC
J1 | 34 | GND | GND
J1 | 35 | GPIO19/LRCLK | I2S_LRCLK
J1 | 36 | GPIO16 | NC
J1 | 37 | GPIO26 | NC
J1 | 38 | GPIO20 | NC
J1 | 39 | GND | GND
J1 | 40 | GPIO21/DIN | I2S_DIN
U1 | 1 | ADDR | GND
U1 | 2 | ALERT/RDY | NC
U1 | 3 | GND | GND
U1 | 4 | AIN0 | KEY_SENSE
U1 | 5 | AIN1 | GND
U1 | 6 | AIN2 | GND
U1 | 7 | AIN3 | GND
U1 | 8 | VDD | +3V3
U1 | 9 | SDA | I2C_SDA
U1 | 10 | SCL | I2C_SCL
U2 | 1 | DIN | I2S_DIN
U2 | 2 | GAIN_SLOT | NC
U2 | 3 | GND | GND
U2 | 4 | SD_MODE | AMP_SD
U2 | 5 | NC | NC
U2 | 6 | NC | NC
U2 | 7 | VDD | +5V
U2 | 8 | VDD | +5V
U2 | 9 | OUTP | SPK_P
U2 | 10 | OUTN | SPK_N
U2 | 11 | GND | GND
U2 | 12 | NC | NC
U2 | 13 | NC | NC
U2 | 14 | LRCLK | I2S_LRCLK
U2 | 15 | GND | GND
U2 | 16 | BCLK | I2S_BCLK
U2 | 17 | EP | GND
J2 | 1 | VCC | +3V3
J2 | 2 | GND | GND
J2 | 3 | DIN | LCD_MOSI
J2 | 4 | CLK | LCD_SCK
J2 | 5 | CS | LCD_CS
J2 | 6 | DC | LCD_DC
J2 | 7 | RST | LCD_RST
J2 | 8 | BL | LCD_BL
J3 | 1 | SPK+ | SPK_P
J3 | 2 | SPK- | SPK_N
J4 | 1 | OUT | KEY_OUT
J4 | 2 | 5V | +5V
J4 | 3 | GND | GND
R1 | 1 | 1 | KEY_OUT
R1 | 2 | 2 | KEY_SENSE
R2 | 1 | 1 | KEY_SENSE
R2 | 2 | 2 | GND
R3 | 1 | 1 | AMP_ENABLE
R3 | 2 | 2 | AMP_SD
R4 | 1 | 1 | AMP_SD
R4 | 2 | 2 | GND
C1 | 1 | 1 | +3V3
C1 | 2 | 2 | GND
C2 | 1 | 1 | +5V
C2 | 2 | 2 | GND
C3 | 1 | 1 | +5V
C3 | 2 | 2 | GND
C4 | 1 | 1 | +5V
C4 | 2 | 2 | GND
TP1 | 1 | 1 | +5V
TP2 | 1 | 1 | +3V3
TP3 | 1 | 1 | GND
TP4 | 1 | 1 | KEY_SENSE
