hvitis/Alfa/design/cloud-radio/generated/cloud/snap-coupon-0.2.3mf

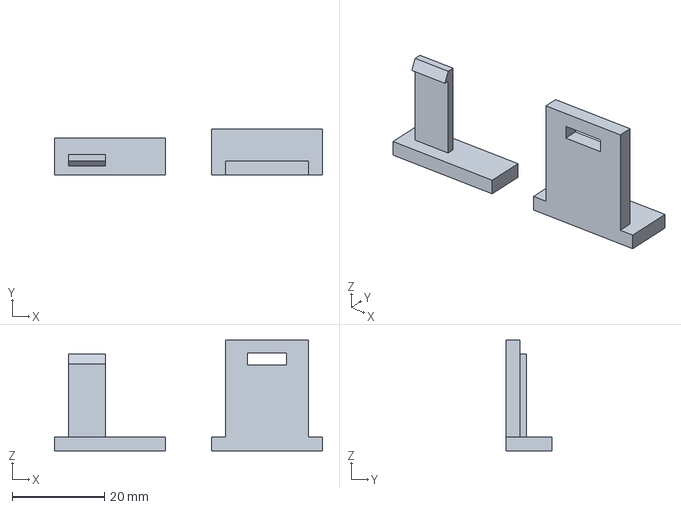
[picture p67: CAD file, 2026-10-23]
design/cloud-radio/generated/cloud/snap-coupon-0.2.3mf
58.0 x 10.0 x 24.0 mm
