hvitis/Alfa/design/pi3-shield/models/ADS1115-DGS.step

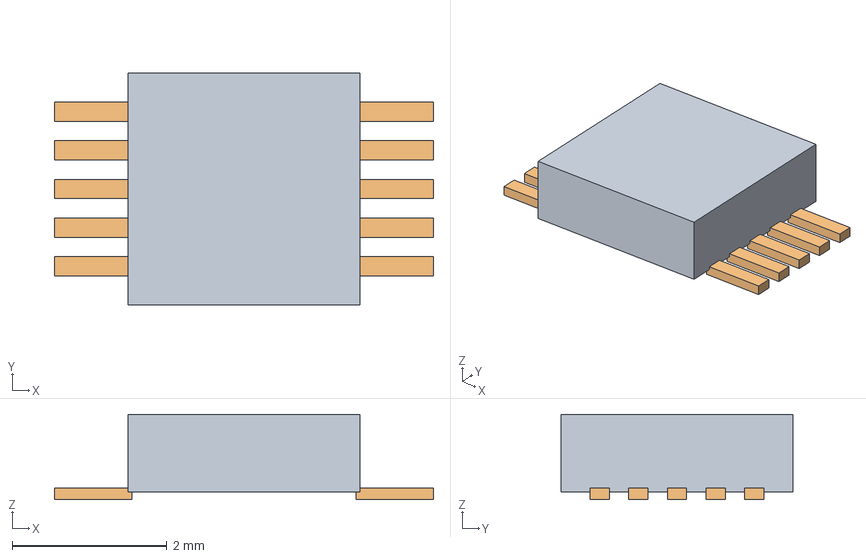
[picture p68: CAD file, 2026-10-17]
design/pi3-shield/models/ADS1115-DGS.step
4.90 x 3.00 x 1.10 mm
Package
Lead1
Lead2
Lead3
Lead4
Lead5
Lead6
Lead7
Lead8
Lead9
Lead10
