hvitis/Alfa/web/v1-snapshot/assets/shield-BdjIoHgB.step

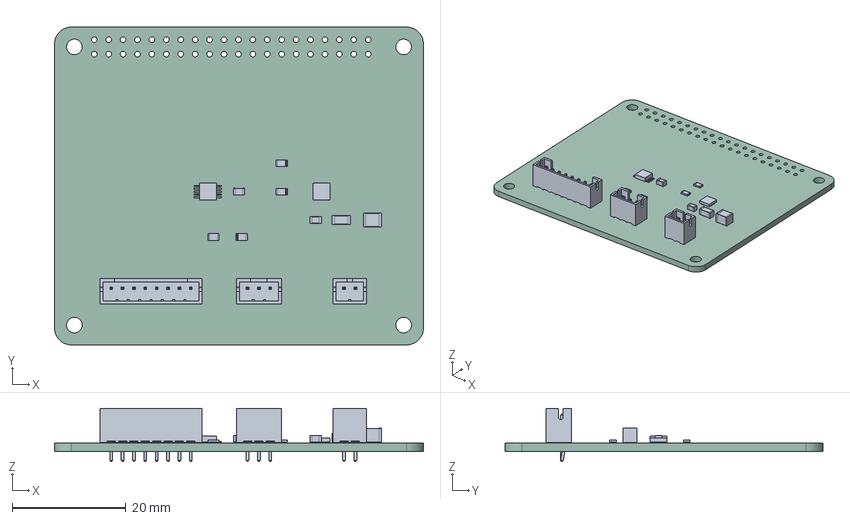
[picture p69: CAD file, 2026-10-18]
web/v1-snapshot/assets/shield-BdjIoHgB.step
65.0 x 56.0 x 9.40 mm
R_0805_2012Metric x 4
Package x 2
Lead1 x 2
Lead2 x 2
Lead3 x 2
Lead4 x 2
Lead5 x 2
Lead6 x 2
Lead7 x 2
Lead8 x 2
Lead9 x 2
Lead10 x 2
Lead11
Lead12
Lead13
Lead14
Lead15
Lead16
Lead17
C_0805_2012Metric x 2
JST_PH_B8B-PH-K_1x08_P2.00mm_Vertical
C_1206_3216Metric
JST_PH_B3B-PH-K_1x03_P2.00mm_Vertical
C_1210_3225Metric
JST_PH_B2B-PH-K_1x02_P2.00mm_Vertical
alfa-pi3-shield_PCB
