hvitis/Alfa/web/v1-snapshot/cloud/battery_door.stl

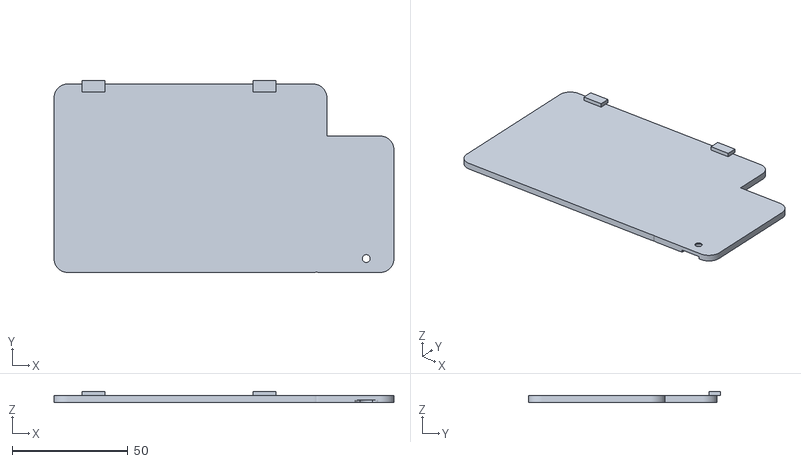
[picture p70: CAD file, 2026-10-18]
web/v1-snapshot/cloud/battery_door.stl
147.0 x 83.0 x 4.80
