hvitis/Alfa/design/cloud-radio/generated/cloud/battery_door.3mf

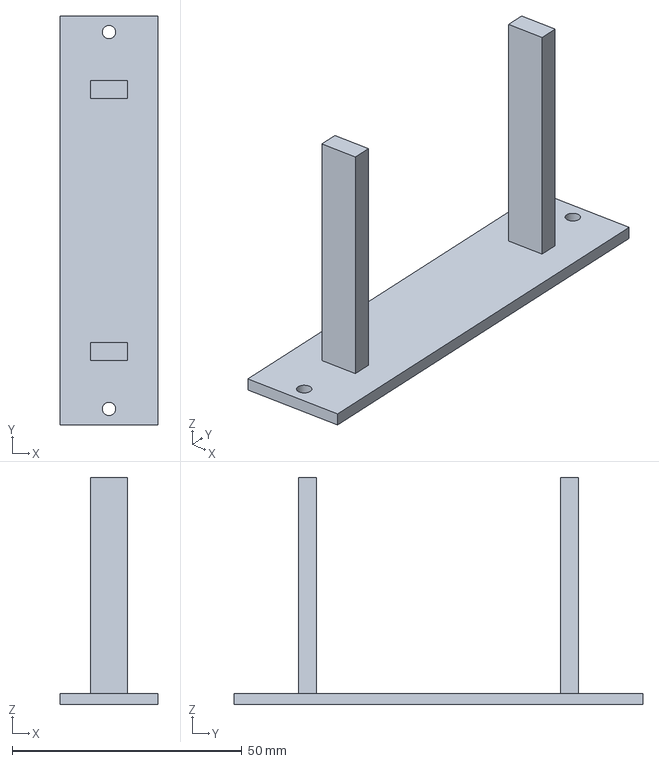
[picture p71: CAD file, 2026-10-23]
design/cloud-radio/generated/cloud/battery_door.3mf
21.4 x 89.0 x 49.4 mm
