hvitis/Alfa/web/v1-snapshot/cloud/snap-coupon-0.4.stl

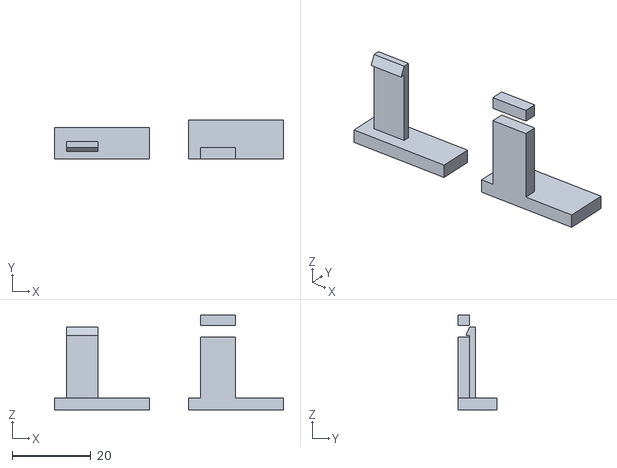
[picture p72: CAD file, 2026-10-18]
web/v1-snapshot/cloud/snap-coupon-0.4.stl
58.0 x 10.0 x 24.0
