hvitis/Alfa/web/v1-snapshot/cloud/cloud-radio.step

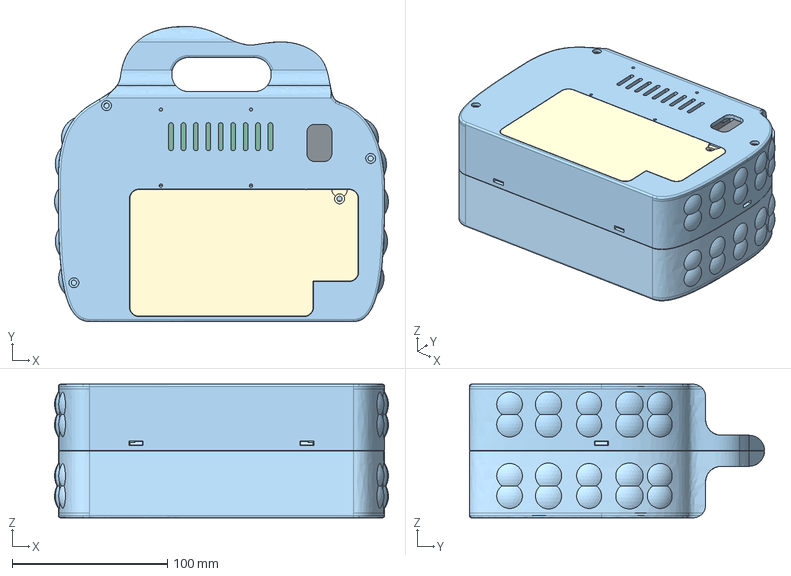
[picture p73: CAD file, 2026-10-18]
web/v1-snapshot/cloud/cloud-radio.step
215.0 x 190.0 x 86.0 mm
front
rear
battery_door
component_battery
component_pi
component_lcd
component_keypad
component_speaker
component_amp
component_adc
component_divider
component_switch
screen
button_0
button_1
button_2
button_3
button_4
connector_pi_ports
connector_gpio
connector_pi_power
connector_bank_plug
connector_usb_join
connector_lcd_cable
