hvitis/Alfa/design/cloud-radio/generated/cloud/front.3mf

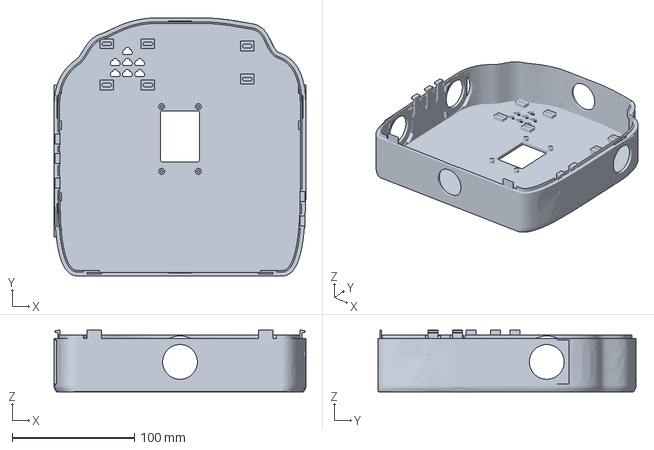
[picture p74: CAD file, 2026-10-23]
design/cloud-radio/generated/cloud/front.3mf
206.0 x 211.0 x 50.5 mm
