hvitis/Alfa/design/cloud-radio/generated/cloud/insert-fit-coupon.3mf

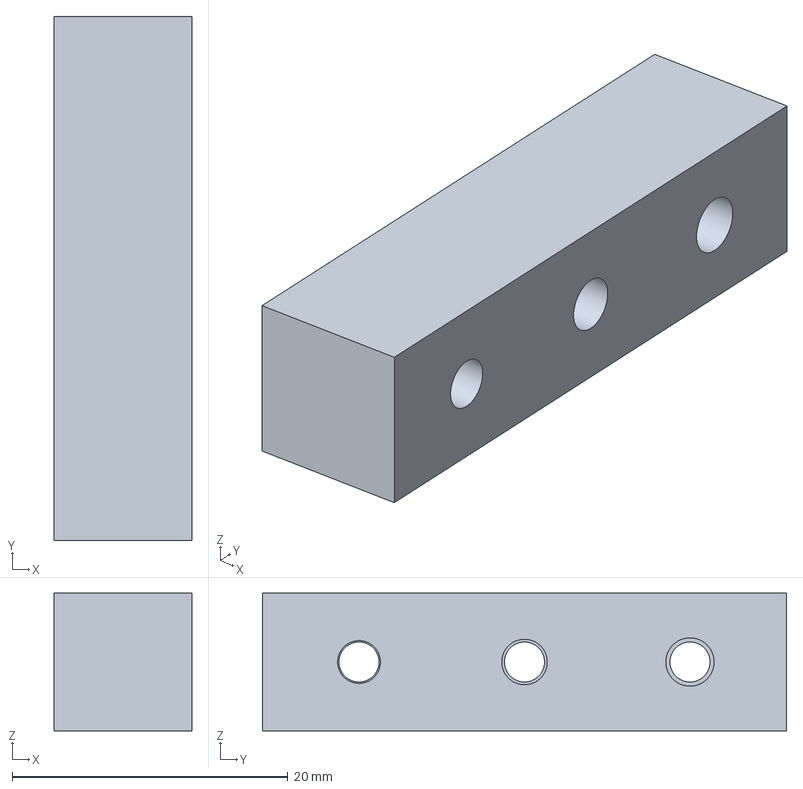
[picture p75: CAD file, 2026-10-23]
design/cloud-radio/generated/cloud/insert-fit-coupon.3mf
10.0 x 38.0 x 10.0 mm
