hvitis/Alfa/design/cloud-radio/generated/cloud/rear.3mf

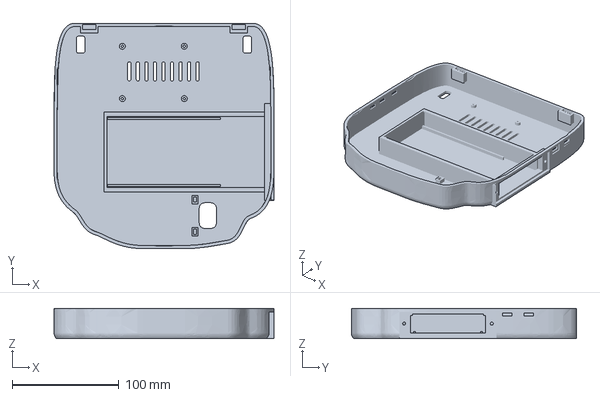
[picture p76: CAD file, 2026-10-23]
design/cloud-radio/generated/cloud/rear.3mf
206.0 x 211.0 x 28.2 mm
