hvitis/Alfa/design/cloud-radio/generated/cloud/button-fit-coupon.3mf

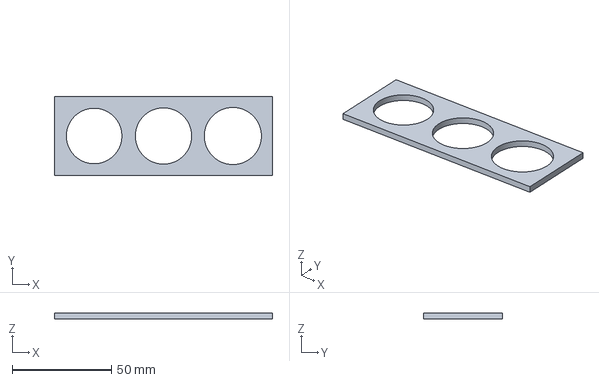
[picture p77: CAD file, 2026-10-23]
design/cloud-radio/generated/cloud/button-fit-coupon.3mf
110.0 x 40.0 x 3.00 mm
