hvitis/Alfa/design/cloud-radio/generated/cloud/cloud-radio.step

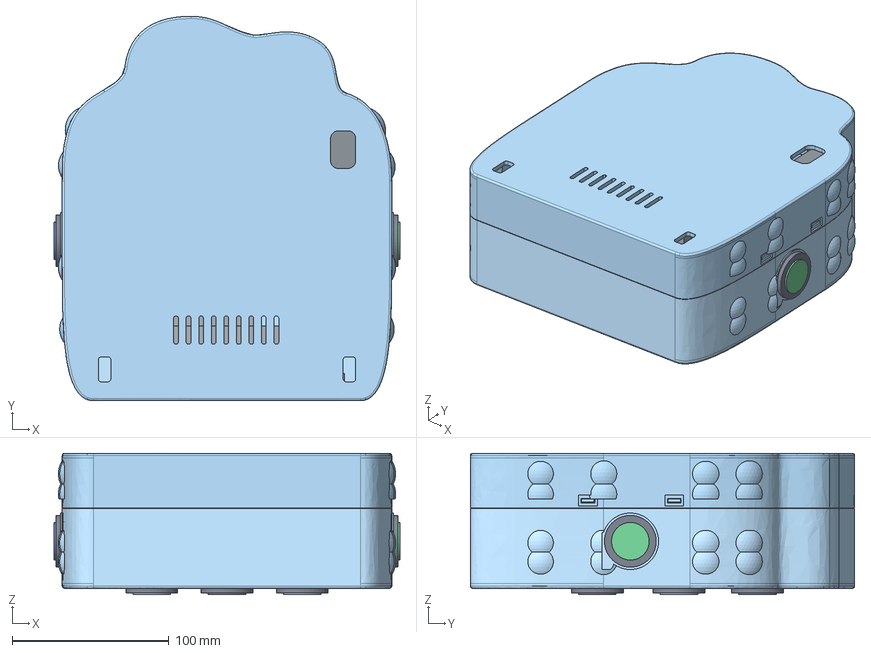
[picture p78: CAD file, 2026-10-19]
design/cloud-radio/generated/cloud/cloud-radio.step
220.5 x 245.0 x 90.0 mm
front
rear
component_battery
component_pi
component_lcd
component_button_top
component_button_bottom
component_button_left
component_button_right
component_button_side_left
component_button_side_right
component_amp
component_switch
component_speaker
screen
bezel_button_top
cap_button_top
bezel_button_bottom
cap_button_bottom
bezel_button_left
cap_button_left
bezel_button_right
cap_button_right
bezel_button_side_left
cap_button_side_left
bezel_button_side_right
cap_button_side_right
connector_pi_ports
connector_gpio
connector_pi_power
connector_bank_plug
connector_usb_join
connector_lcd_cable
connector_button_top_nut
connector_button_top_wires
connector_button_bottom_nut
connector_button_bottom_wires
connector_button_left_nut
connector_button_left_wires
connector_button_right_nut
connector_button_right_wires
connector_button_side_left_nut
connector_button_side_left_wires
connector_button_side_right_nut
connector_button_side_right_wires
