hvitis/Alfa/design/pi3-shield/models/MAX98357A-T1633.step

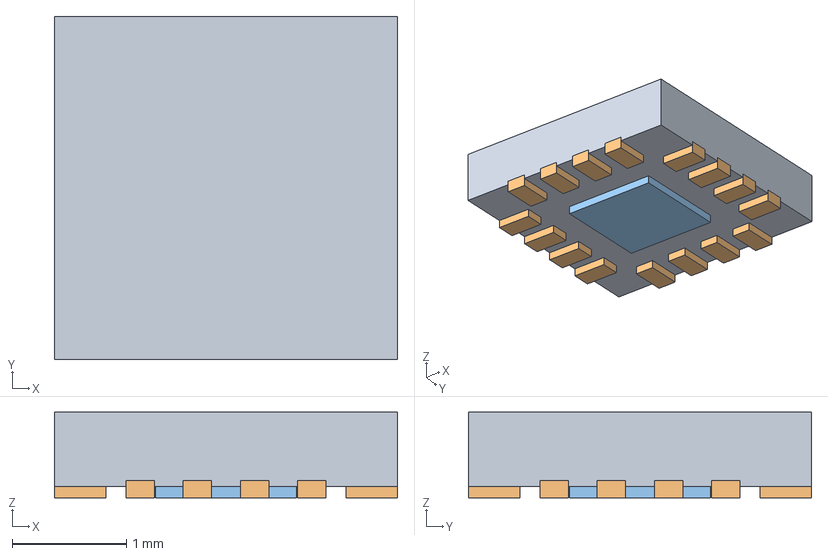
[picture p79: CAD file, 2026-10-17]
design/pi3-shield/models/MAX98357A-T1633.step
3.00 x 3.00 x 0.75 mm
Package
Lead1
Lead2
Lead3
Lead4
Lead5
Lead6
Lead7
Lead8
Lead9
Lead10
Lead11
Lead12
Lead13
Lead14
Lead15
Lead16
Lead17
