hvitis/Alfa/(list of files, cad)

Other CAD files:
design/cloud-radio/generated/cloud/snap-coupon-0.3.3mf
design/cloud-radio/generated/cloud/snap-coupon-0.4.3mf
design/cloud-radio/generated/cloud/cloud-ender.scad
design/cloud-radio/generated/cloud/battery_door.stl
design/cloud-radio/generated/cloud/button-fit-coupon.stl
design/cloud-radio/generated/cloud/front.stl
design/cloud-radio/generated/cloud/insert-fit-coupon.stl
design/cloud-radio/generated/cloud/rear.stl
design/cloud-radio/generated/cloud/snap-coupon-0.2.stl
design/cloud-radio/generated/cloud/snap-coupon-0.3.stl
design/cloud-radio/generated/cloud/snap-coupon-0.4.stl
