hvitis/Alfa/output/wiring-3d.html

ALFA / HARDWARE

# Understand every module and connection.

Click any module to learn its purpose. Compare the Pi 3 and Pico setups, or inspect the resistor divider.

CHANGED CONTROLLERPi 3 → Pi ZeroCompact header · WiFi · Bluetooth · fitted pins

CHANGED CONNECTIONS19 header wires moveNew physical pins + GP numbers. Amber marks the changed pins.

NEW SUPPLY JOINS3.3 V + USB 5 V splitsTwo modules share each supply. VBUS needs USB power.

CHANGED SOFTWAREPi Zero firmware + PIO audioSPI screen + I2C ADC. The Linux/SSH app needs a port.

PICO VIEW Changed controller / pins Selected module

WOODEN CASE · WORKSHOP PLANNER

Assembled · front facing you

150 × 200 × 64 mm · 6 mm plywood · 4 × A4 sheets

ALFA · LITTLE HOUSE RADIO

Assembled

Left-drag: orbit · Right-drag: pan · Wheel: zoom · WASD: move · Q/E: down/up

Move camera

UpForwardDown LeftBackRight

Purple join = R1 leg B + R2 leg A + ADC A0 wire.

CLICK A MODULE IN 3D OR CHOOSE ONE

## What does each module do?

Look closer at this module

WOODEN CASE · WORKSHOP PLANNER

## Explore the enclosure

AssembledInsideExploded

FrontRear3D Iso

Show plywood walls Component labels Trace wire

Before cutting: Print PDF at 100% and measure 100 mm line. Check keypad opening and switch housing against physical parts.

Rear cover: four M3 screws. Pi on 8 mm standoffs. Lift 20 mm and disconnect power before opening fully.

1:1 Cutting PDF ↗ Wiring PDF ↗ STEP CAD ↗

WOODEN RADIO · ALFA · FULL DESIGN

## Little House Radio

Concept B, complete: every panel, hinge, magnet, screw and wire. Click a part or a wire; hide the plywood to look inside.

AssembledRoof openInsideExploded

Show plywood Component labels Wire group Trace wire

Charging: pull the two roof knobs up and out; both halves stand upright. The power bank's USB-C socket is under the ridge. Fold the halves down and the magnets click them shut.

Screws, calculated from the parts they hold

Earlier concepts (step 1)

Concept drawings PDF ↗

YOUR BOARD · PHOTO _003

## Five buttons · three pins

Component side up. Four directional buttons and one lower button. The right-angle header is at the bottom-right: OUT, VCC, GND from top to bottom.

Look closer at button module

Printed pin | Connection
OUT
VCC
GND

OUT connects to R1. VCC receives 5 V. GND shares controller and ADC ground. The three sockets fit the long horizontal header pins.

YOUR BOARD · BUT1 / BUT2

## ADC pins & connections

Label side up, header on the right: V, G, SCL, SDA, ADDR, ALERT, A0, A1, A2, A3. The black spacer and long pins are on the component side. Board enlarged for clarity.

Labels & wiringComponent side

Look closer at ADC

Printed pin | Connection

V means VDD; G means GND. A0 connects to the R1/R2 join. ADDR connects to G. ALERT and A1–A3 stay unwired.

G is a shared connection: the marked ground join connects controller ground, R2 and ADDR. One yellow lead runs from that join to G. Wire colors identify connections in this diagram.

Yellow · all ground branches: controller, R2, ADDR and GPurple · join → A0

YOUR BOARD · HEADER ORDER VERIFIED IN MAX4

## Amplifier assembly & wiring

Component side up. Green speaker block at the top; yellow seven-pin header at the bottom. Board enlarged for clarity.

Connect cablesBefore solderingSolder underside

Look closer at amplifier

Header label | Pi 3 connection

Seven solder joints, five jumper wires. Solder all seven header pins. Leave GAIN and SD without external wires.

Green screw terminalLeft − → speaker −Right + → speaker +

Loosen each screw, insert the stripped speaker wire into its wire entry opening, then tighten. Neither speaker wire connects to GND.

Disconnect Pi power before soldering or moving wires. The long header pins face upward; solder the short legs on the back.

PI 3 → PICO · WHAT CHANGES

## Same modules. New controller.

Compare all 19 header connections

Terminal | Pi 3 pin | Pico physical pin / GP

Pico wiring is a proposed firmware pin assignment. The Linux app in app/ is for the Pi 3. The Pico needs separate firmware.

TWO RESISTORS · BOTH 10 kΩ

## One shared join. Three connections.

Join these three ends together: R1 leg B, R2 leg A, and the ADC A0 wire.

Shared join

This is one electrical connection. It is not a third component.

Resistors have no + or −. Either end can be leg A. The labels only help you follow this drawing.

Make the join with solder, or use one connected breadboard row. Separate breadboard rows do not connect automatically.

R1 reduces the signal together with R2. With two equal resistors, 5 V at OUT becomes about 2.5 V at A0.

ALL DEVICES TOGETHER

## Trace one cable at a time.

Pi numbers are physical header pins. Click a cable or a row below to display both endpoint labels.

The group selector moves the camera closer and hides the other cables.

## The complete resistor connection

Keypad OUT → R1 → shared join → ADC A0

Shared join → R2 → GND

Keypad: 5 V. ADC: 3.3 V. All GND connections share Pi ground.

The ADC header order follows but2.jpg. V = VDD, G = GND. Disconnect Pi power before changing wires.

Three.js 3D viewer · The Pi test software stays in app/. Open the resistor image
