hvitis/Alfa/docs/images/cloud-assembly.png

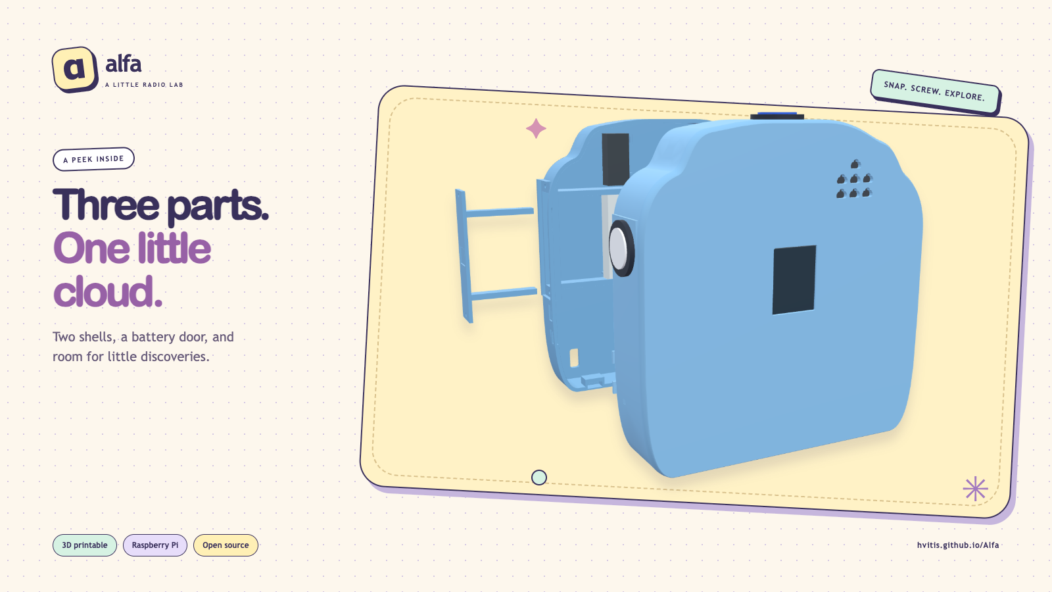
docs/images/cloud-assembly.png
