hvitis/Alfa/output/wiring-adc.png

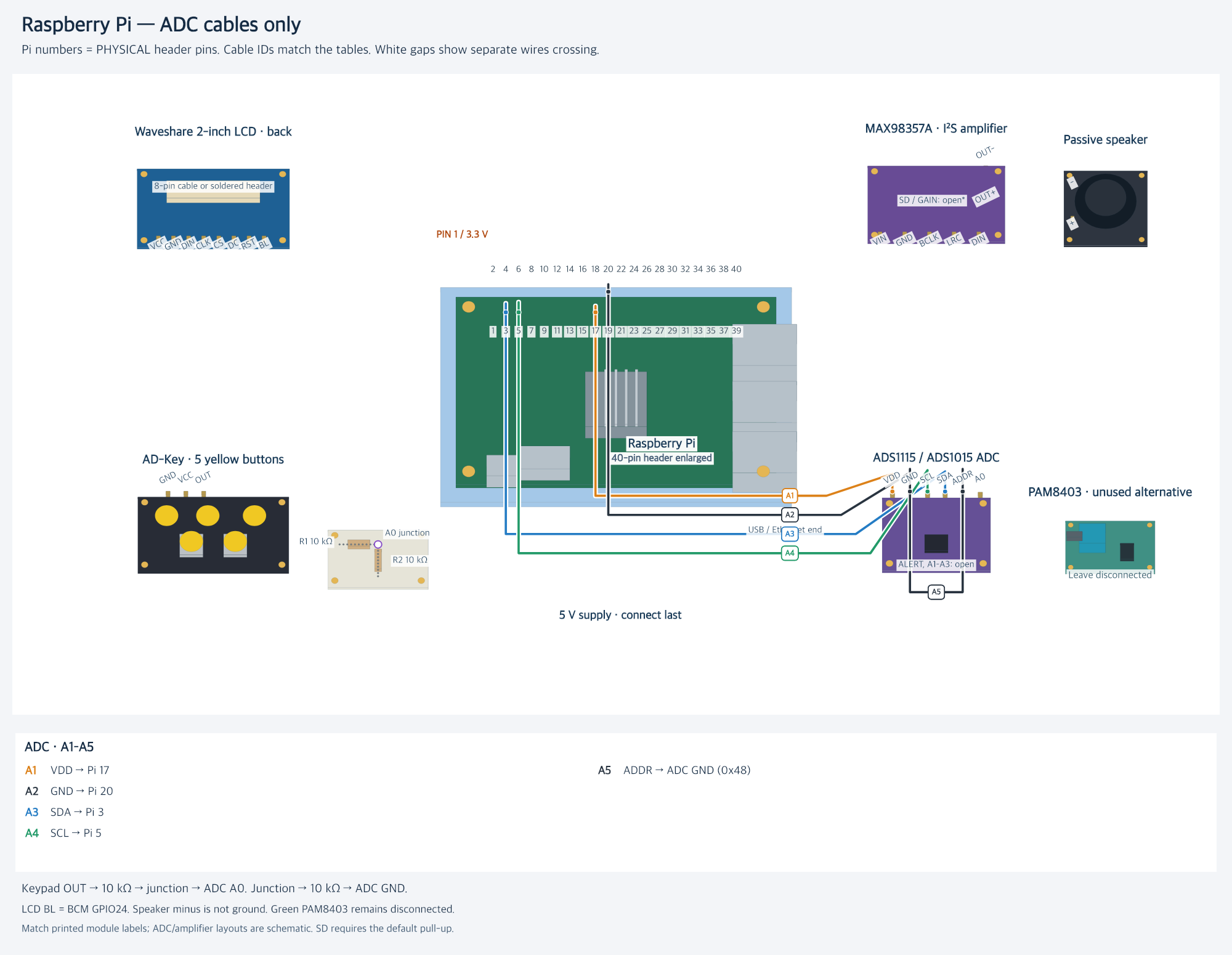
output/wiring-adc.png
