hvitis/Alfa/output/illustration-unverified-pin-placement.png

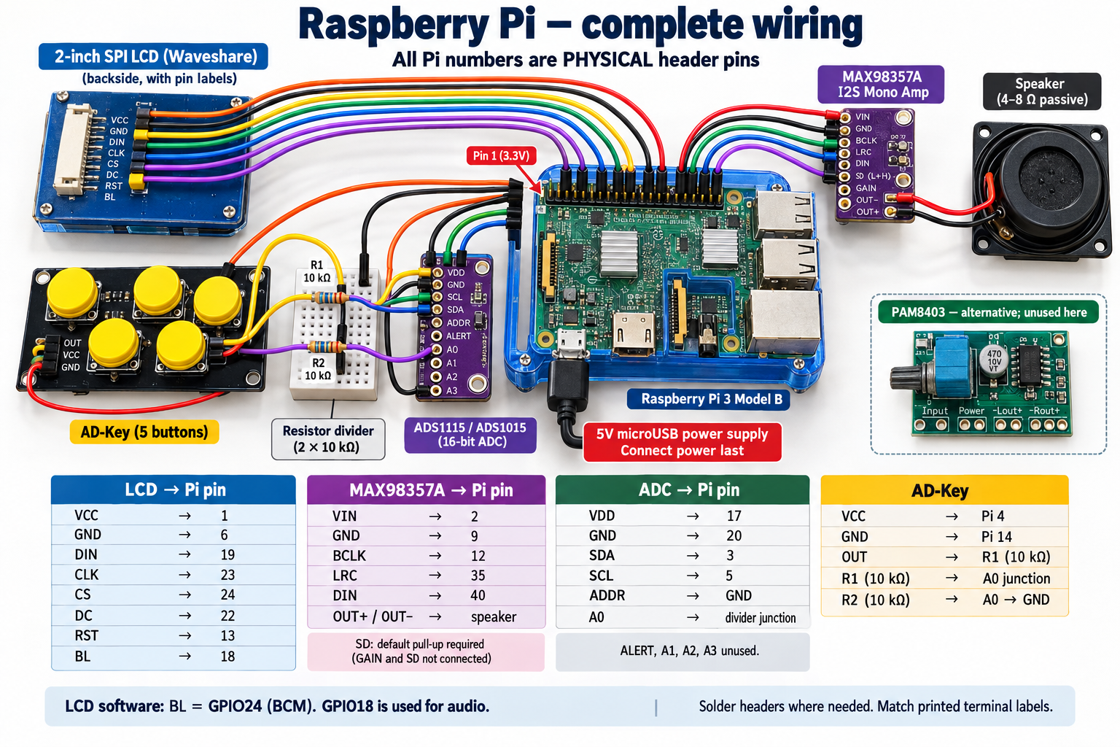
output/illustration-unverified-pin-placement.png
