hvitis/Alfa/docs/alphabet-revisions.png

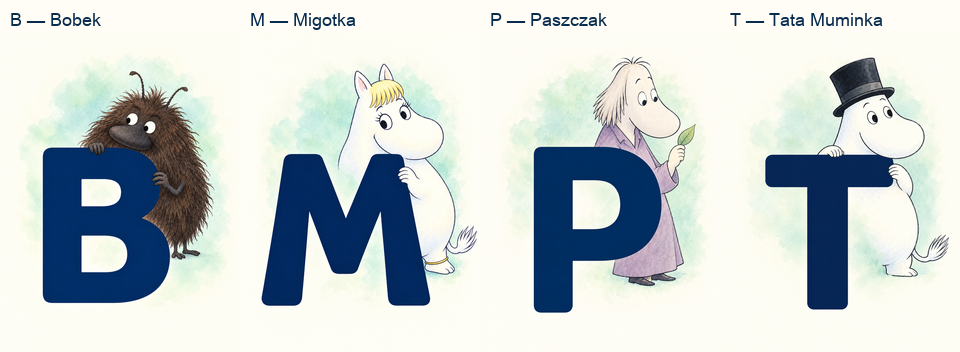
docs/alphabet-revisions.png
