hvitis/Alfa/web/v1-snapshot/assets/schematic-C7eL0Mz1.pdf

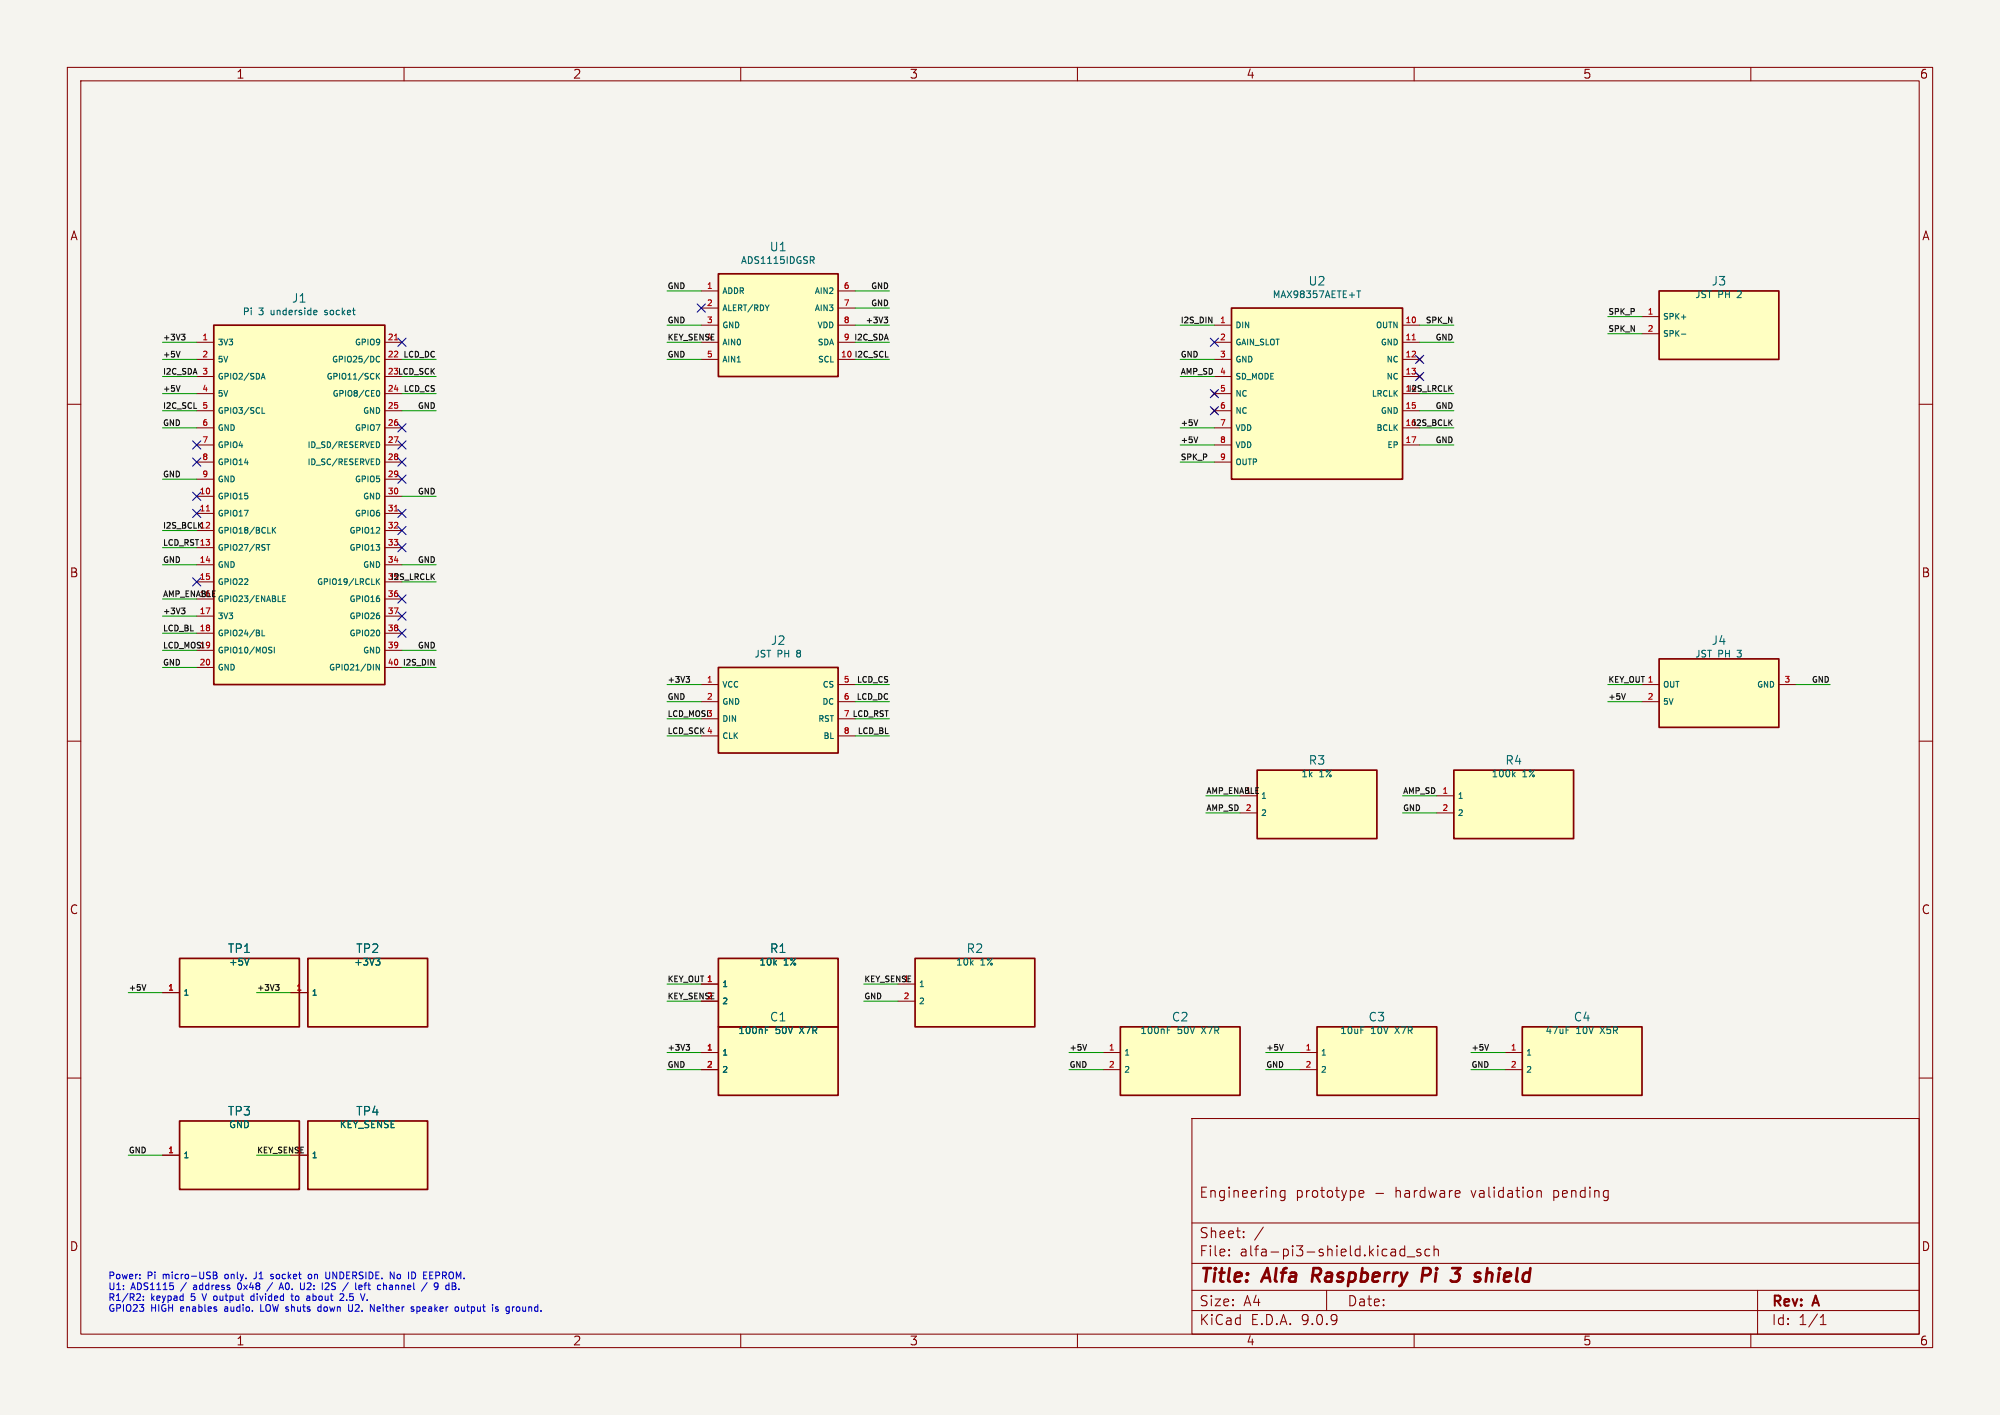
[picture p105: page 1]

Id: 1/1 Title: Alfa Raspberry Pi 3 shield
