hvitis/Alfa/design/pi3-shield/generated/assembly-bottom.pdf

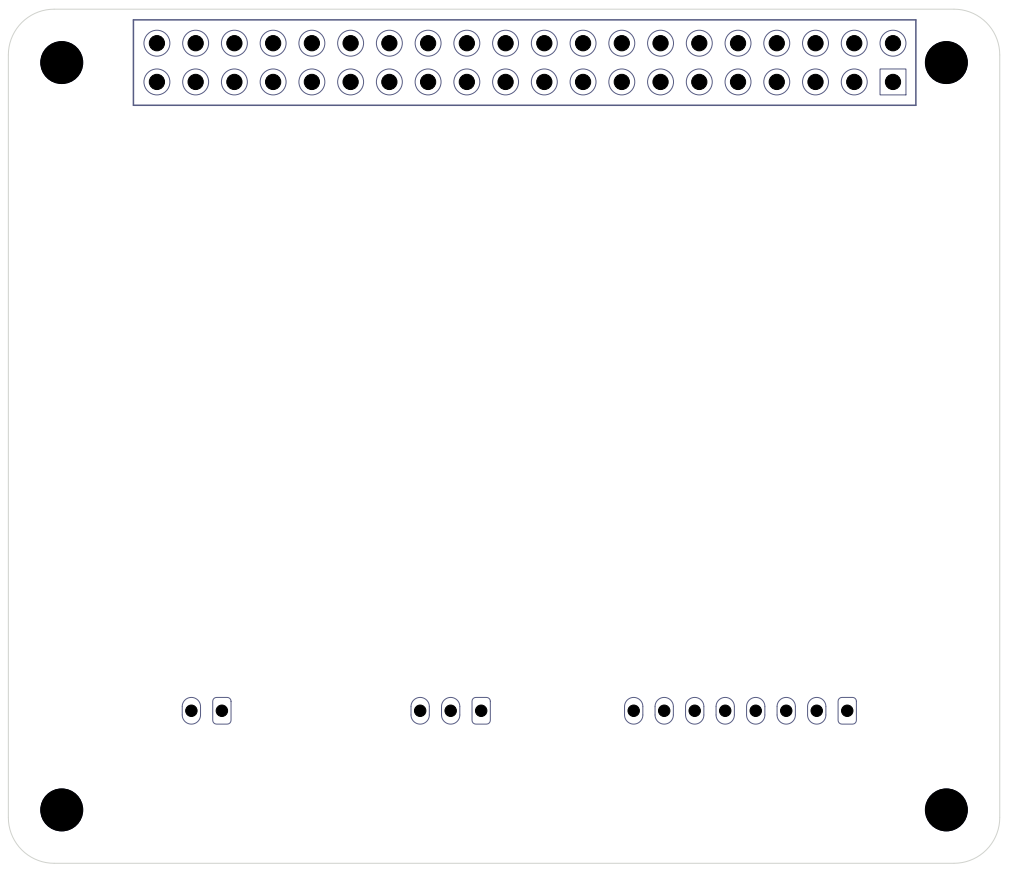
[picture p106: page 1]
