hvitis/Alfa/design/pi3-shield/generated/assembly-top.pdf

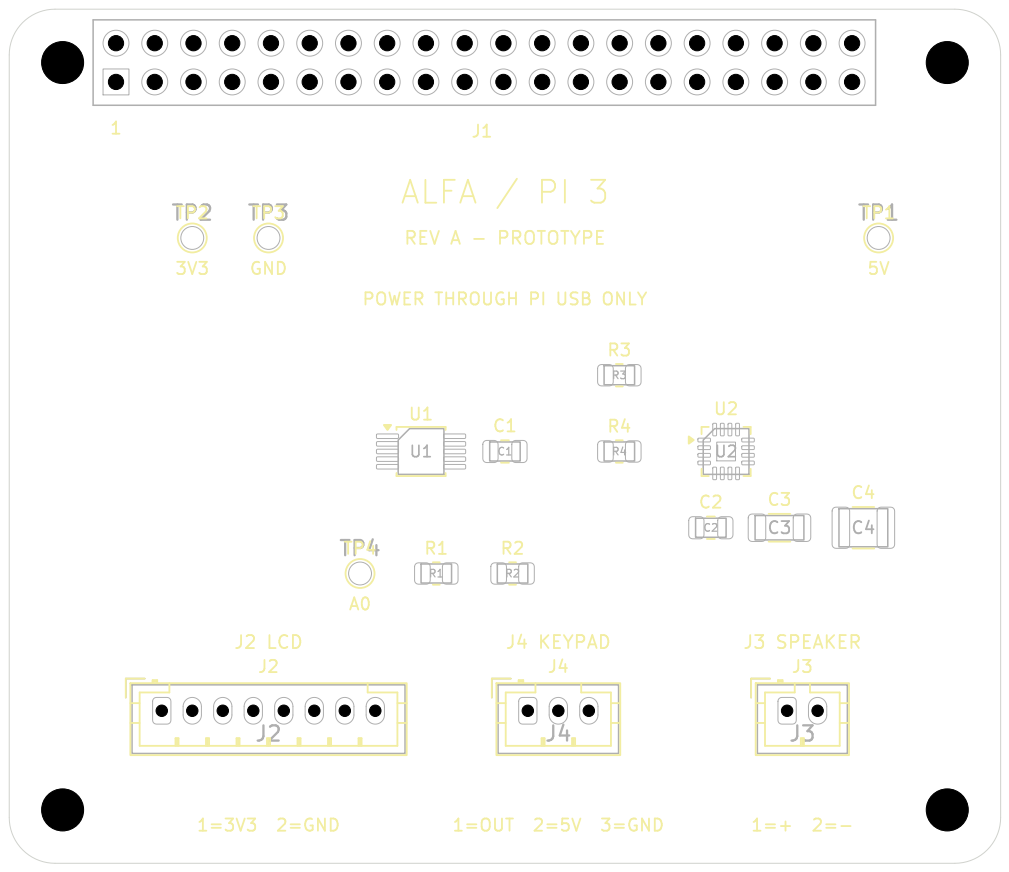
[picture p107: page 1]

A0POWER THROUGH PI USB ONLY
