hvitis/Alfa/design/pi3-shield/alfa-pi3-shield.kicad_pcb

## KiCad design design/pi3-shield/alfa-pi3-shield.kicad_pcb (2026-10-17)

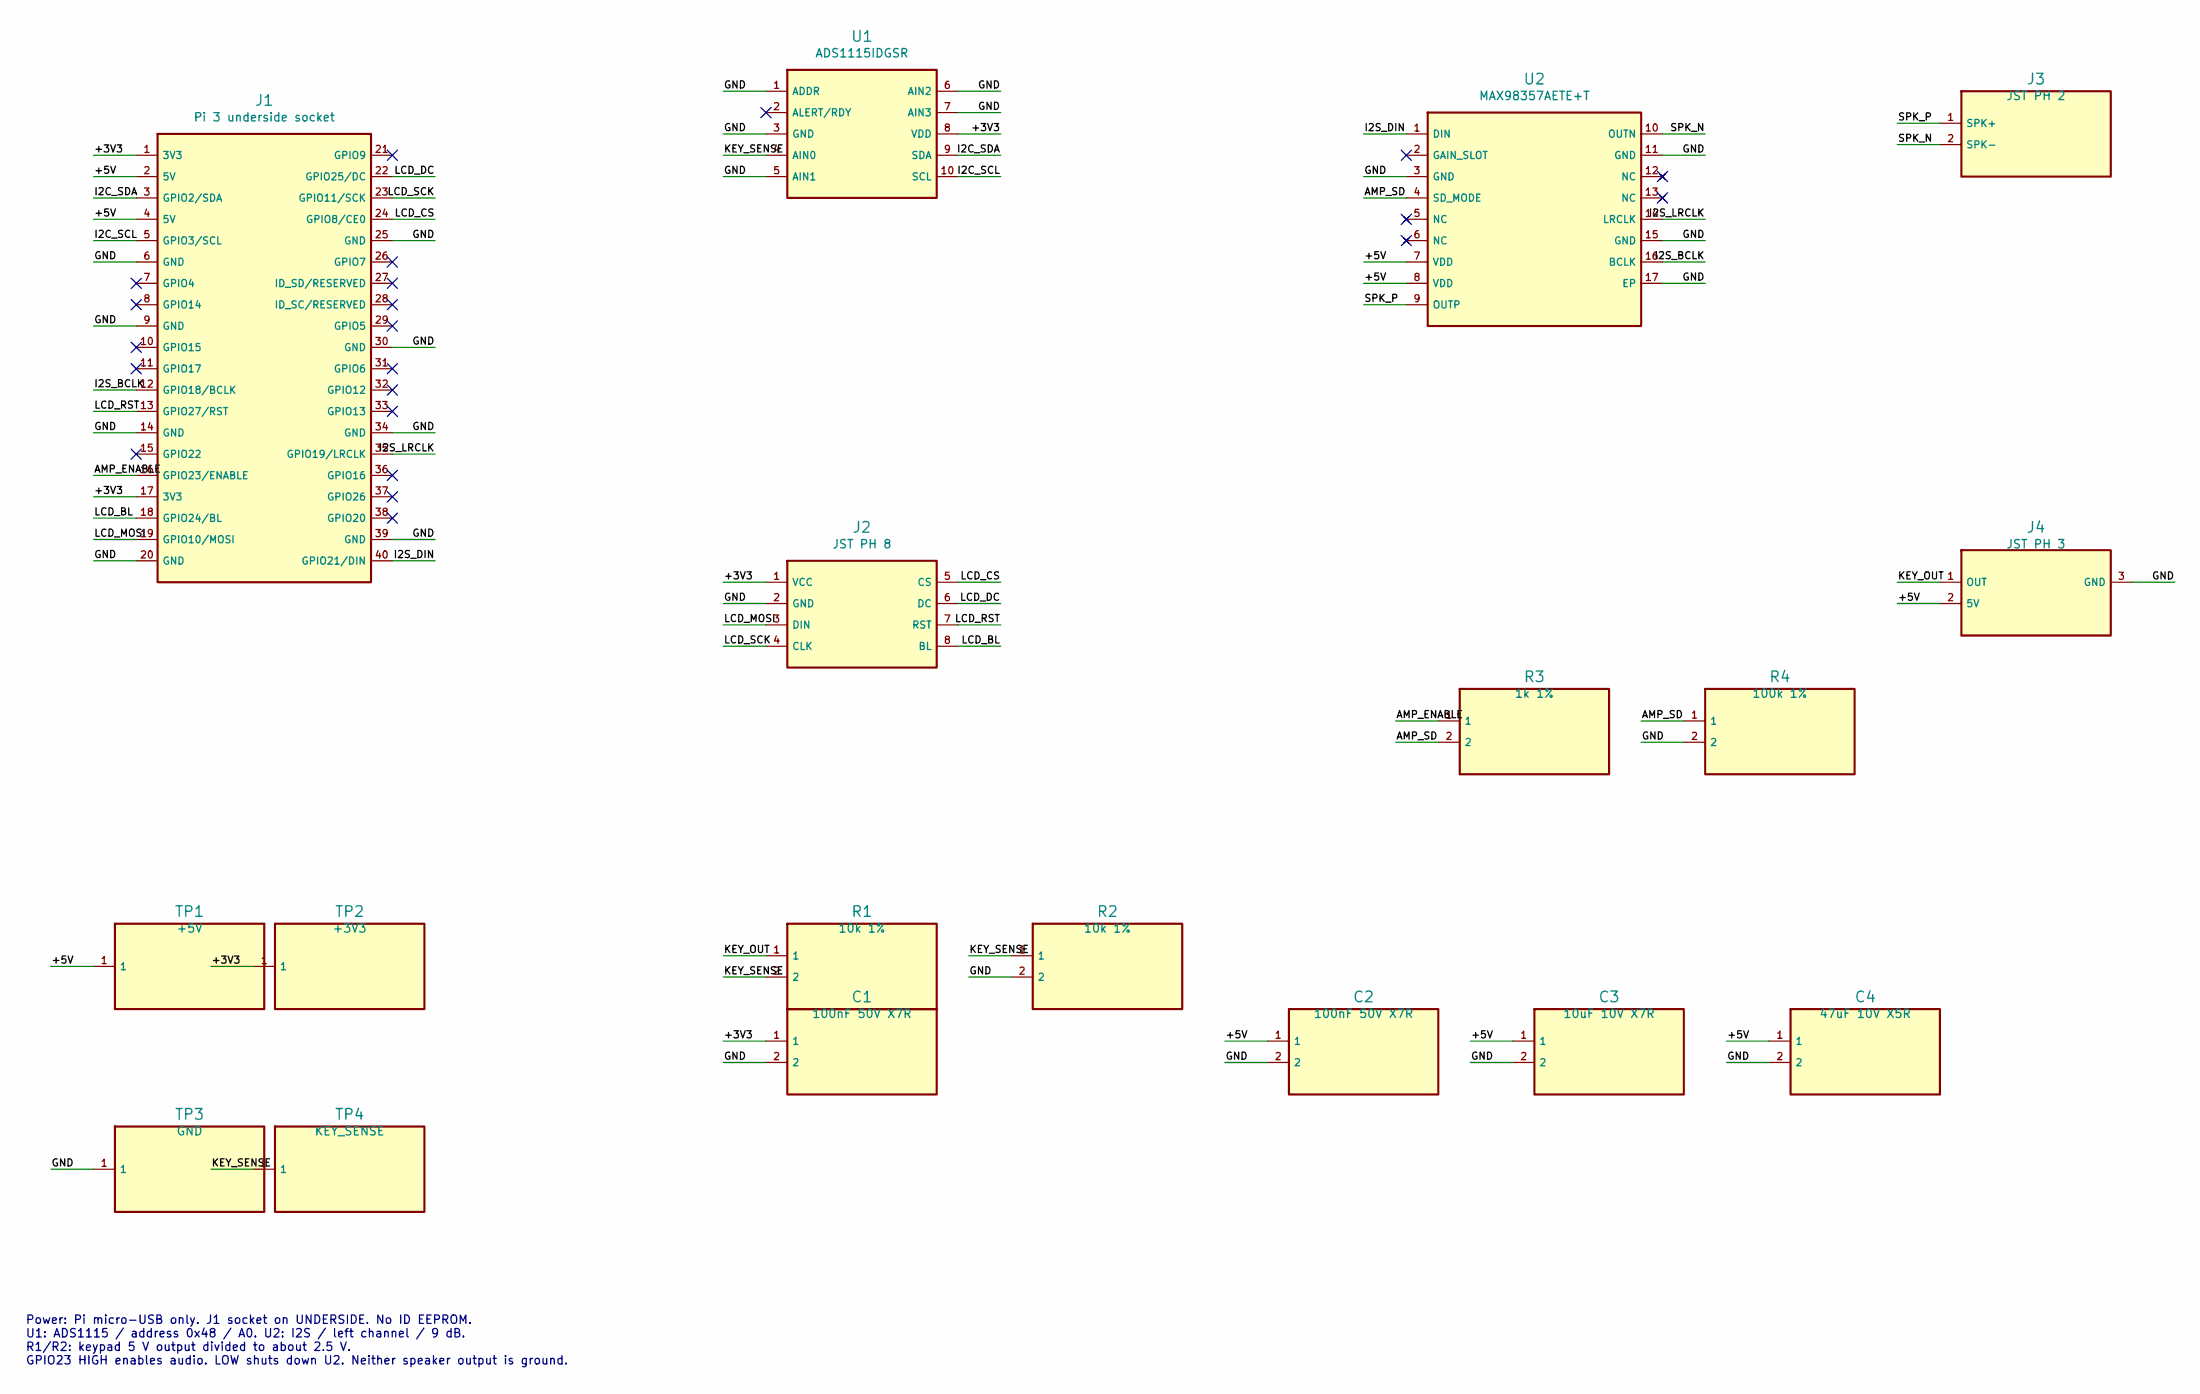
[picture p108: schematic alfa-pi3-shield.kicad_sch, Alfa Raspberry Pi 3 shield]

Parts:
C1, C2: 100nF 50V X7R; C_0805_2012Metric; MPN GRM21BR71H104KA01L
C3: 10uF 10V X7R; C_1206_3216Metric; MPN GRM31CR71A106KA01L
C4: 47uF 10V X5R; C_1210_3225Metric; MPN GRM32ER61A476KE20L
J1: Pi 3 underside socket; Pi_40_Underside; MPN SSQ-120-01-G-D
J2: JST PH 8; JST_PH_B8B-PH-K_1x08_P2.00mm_Vertical; MPN B8B-PH-K-S(LF)(SN)
J3: JST PH 2; JST_PH_B2B-PH-K_1x02_P2.00mm_Vertical; MPN B2B-PH-K-S(LF)(SN)
J4: JST PH 3; JST_PH_B3B-PH-K_1x03_P2.00mm_Vertical; MPN B3B-PH-K-S(LF)(SN)
R1, R2: 10k 1%; R_0805_2012Metric; MPN RC0805FR-0710KL
R3: 1k 1%; R_0805_2012Metric; MPN RC0805FR-071KL
R4: 100k 1%; R_0805_2012Metric; MPN RC0805FR-07100KL
TP1: +5V; TestPoint_Pad_D1.5mm
TP2: +3V3; TestPoint_Pad_D1.5mm
TP3: GND; TestPoint_Pad_D1.5mm
TP4: KEY_SENSE; TestPoint_Pad_D1.5mm
U1: ADS1115IDGSR; VSSOP-10_3x3mm_P0.5mm; MPN ADS1115IDGSR
U2: MAX98357AETE+T; TQFN-16-1EP_3x3mm_P0.5mm_EP1.23x1.23mm; MPN MAX98357AETE+T

Connections:
+3V3: C1.1, J1.1 (3V3), J1.17 (3V3), J2.1 (VCC), TP2.1, U1.8 (VDD)
+5V: C2.1, C3.1, C4.1, J1.2 (5V), J1.4 (5V), J4.2 (5V), TP1.1, U2.7 (VDD), U2.8 (VDD)
AMP_ENABLE: J1.16 (GPIO23/ENABLE), R3.1
AMP_SD: R3.2, R4.1, U2.4 (SD_MODE)
GND: C1.2, C2.2, C3.2, C4.2, J1.6 (GND), J1.9 (GND), J1.14 (GND), J1.20 (GND), J1.25 (GND), J1.30 (GND), J1.34 (GND), J1.39 (GND), J2.2 (GND), J4.3 (GND), R2.2, R4.2, TP3.1, U1.1 (ADDR), U1.3 (GND), U1.5 (AIN1), U1.6 (AIN2), U1.7 (AIN3), U2.3 (GND), U2.11 (GND), U2.15 (GND), U2.17 (EP)
I2C_SCL: J1.5 (GPIO3/SCL), U1.10 (SCL)
I2C_SDA: J1.3 (GPIO2/SDA), U1.9 (SDA)
I2S_BCLK: J1.12 (GPIO18/BCLK), U2.16 (BCLK)
I2S_DIN: J1.40 (GPIO21/DIN), U2.1 (DIN)
I2S_LRCLK: J1.35 (GPIO19/LRCLK), U2.14 (LRCLK)
KEY_OUT: J4.1 (OUT), R1.1
KEY_SENSE: R1.2, R2.1, TP4.1, U1.4 (AIN0)
LCD_BL: J1.18 (GPIO24/BL), J2.8 (BL)
LCD_CS: J1.24 (GPIO8/CE0), J2.5 (CS)
LCD_DC: J1.22 (GPIO25/DC), J2.6 (DC)
LCD_MOSI: J1.19 (GPIO10/MOSI), J2.3 (DIN)
LCD_RST: J1.13 (GPIO27/RST), J2.7 (RST)
LCD_SCK: J1.23 (GPIO11/SCK), J2.4 (CLK)
SPK_N: J3.2 (SPK-), U2.10 (OUTN)
SPK_P: J3.1 (SPK+), U2.9 (OUTP)

Notes on the sheet:
Power: Pi micro-USB only. J1 socket on UNDERSIDE. No ID EEPROM. U1: ADS1115 / address 0x48 / A0. U2: I2S / left channel / 9 dB. R1/R2: keypad 5 V output divided to about 2.5 V. GPIO23 HIGH enables audio. LOW shuts down U2. Neither speaker output is ground.

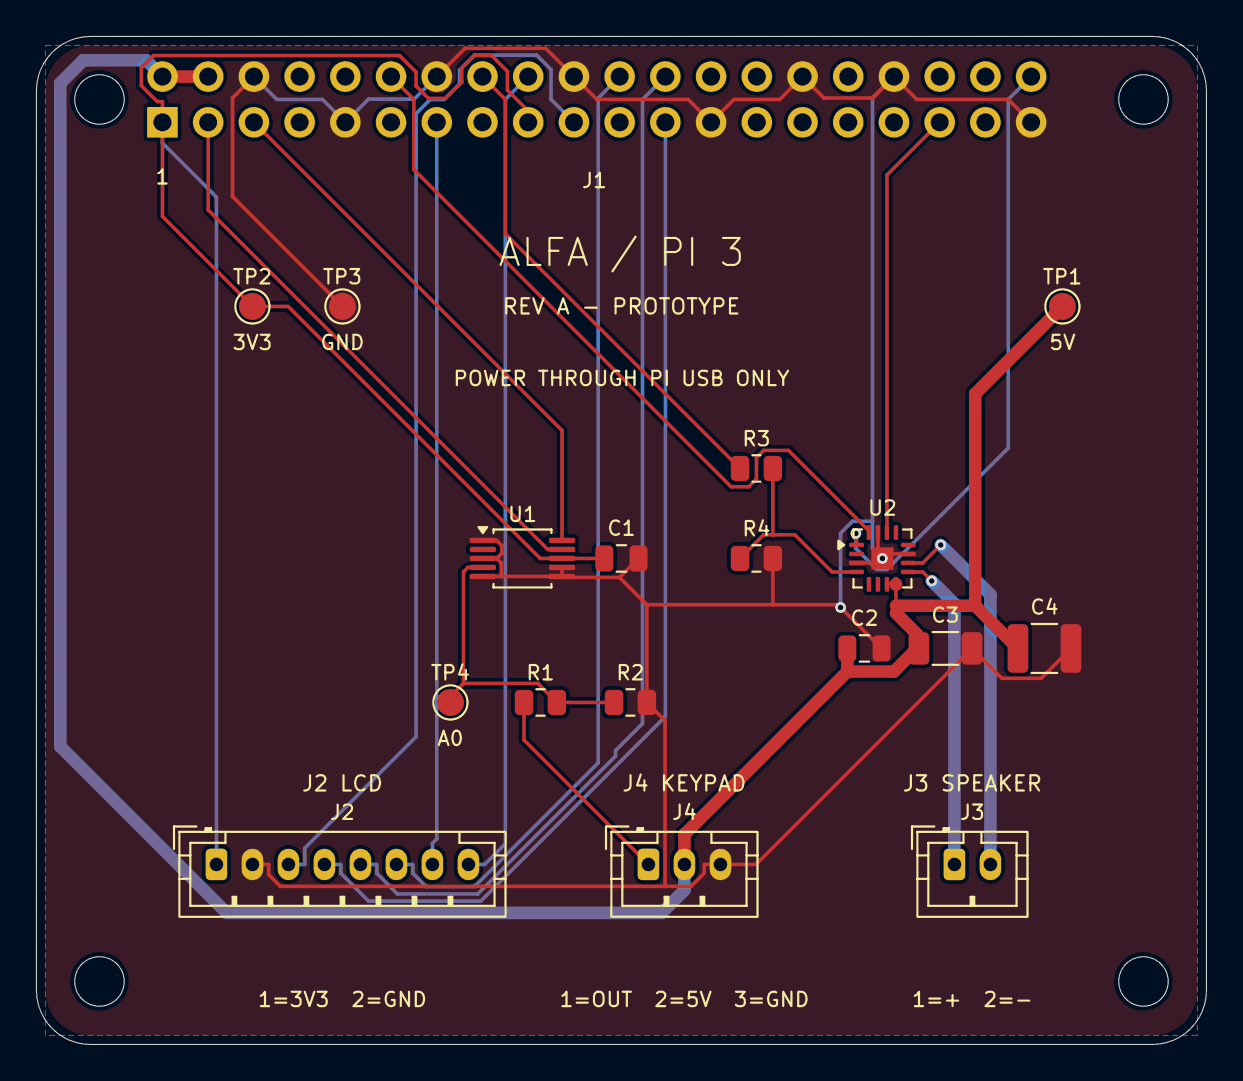
[picture p109: board alfa-pi3-shield.kicad_pcb from above]

Board: 2 copper layers, 65.0 x 56.0 mm, 22 parts (1 on the bottom side), 20 nets.

Other parts of the board:
H1, H2, H3, H4: MountingHole_2.7mm_M2.5
