hvitis/Alfa/app/animation.py

"""Short, interruptible portrait animations, with precompiled ST7789 transfers."""
import json
import time
from pathlib import Path

from PIL import Image


class CharacterAnimation:
    def __init__(self, directory, fps=5, cycles=2, rotation=0, clock=time.monotonic, clip_options=None):
        self.directory = Path(directory)
        manifest = json.loads((self.directory / "manifest.json").read_text())
        if manifest.get("size") != [240, 320] or manifest.get("wire_format") != "RGB565-BE":
            raise ValueError("Animation manifest must specify 240x320 RGB565-BE wire frames.")
        self.clips = manifest["clips"]
        for frames in self.clips.values():
            if not 2 <= len(frames) <= 32:
                raise ValueError("Character animations need 2 to 32 frames.")
            for frame in frames:
                for key in ("png", "bin"):
                    path = Path(frame[key])
                    if path.is_absolute() or ".." in path.parts:
                        raise ValueError("Animation frames must stay inside the media directory.")
                    if not (self.directory / path).is_file():
                        raise ValueError(f"Missing animation frame: {path}")
        self.fps, self.cycles, self.rotation, self.clock = fps, cycles, rotation, clock
        self.default_fps, self.default_cycles = fps, cycles
        self.clip_options = clip_options or {}
        self.active = None
        self.started = 0
        self.serial = 0
        self.payloads = []
        self.payload_index = None

    def start(self, name, minimum_seconds=0):
        if name not in self.clips:
            raise ValueError(f"Unknown animation: {name}")
        # One native frame (153600 bytes), loaded only when it reaches the screen.
        self.payloads, self.payload_index = [], None
        self.active, self.started = name, self.clock()
        options = self.clip_options.get(name, {})
        self.fps = options.get("fps", self.default_fps)
        self.cycles = options.get("cycles", self.default_cycles)
        self.duration = max(len(self.clips[name]) * self.cycles / self.fps, minimum_seconds)
        self.serial += 1

    def first_frame(self, name):
        return self.load_frame(name, 0)

    def load_frame(self, name, index):
        with Image.open(self.directory / self.clips[name][index]["png"]) as source:
            if source.size != (240, 320):
                raise ValueError("Animation PNG must be 240x320.")
            return source.convert("RGB")

    def stop(self):
        self.active = None
        self.payloads = []
        self.payload_index = None

    def index(self):
        if self.active is None:
            return None
        tick = int(max(0, self.clock() - self.started) * self.fps)
        count = len(self.clips[self.active])
        if self.clock() - self.started >= self.duration:
            self.stop()
            return None
        return tick % count

    def render_key(self):
        index = self.index()
        return (self.active, self.serial, index)

    def frame(self):
        index = self.index()
        if index is None:
            return None
        return self.load_frame(self.active, index)

    def wire_frame(self):
        index = self.index()
        if index is None:
            return None
        if index != self.payload_index:
            self.payloads = []
            frame = self.clips[self.active][index]
            payload = (self.directory / frame["bin"]).read_bytes()
            if len(payload) != 240 * 320 * 2:
                raise ValueError(f"Invalid RGB565 frame length: {frame['bin']}")
            if self.rotation == 180:
                from array import array
                words = array("H", payload)
                words.reverse()
                payload = words.tobytes()
            self.payloads, self.payload_index = [payload], index
        return self.payloads[0]
