hvitis/Alfa/tests/test_animation.py

import copy
import importlib.util
import tempfile
import unittest
from pathlib import Path
from unittest.mock import patch

from PIL import Image, ImageChops

from app.animation import CharacterAnimation
from app.app import run_gallery
from app.audio import StreamingAudioPlayer
from app.config import ROOT, Settings
from app.hardware import ST7789, rgb565
from app.player import PlayerSession


class AnimationTests(unittest.TestCase):
    def setUp(self):
        self.temp = tempfile.TemporaryDirectory()
        self.addCleanup(self.temp.cleanup)
        self.root = Path(self.temp.name)
        self.now = 100.0
        self.animation = CharacterAnimation(ROOT / "media/animations", clock=lambda: self.now)
        self.settings = Settings(self.root, copy.deepcopy(Settings.load().data))
        self.audio = StreamingAudioPlayer(self.settings, simulate=True)
        self.addCleanup(self.audio.close)
        self.photos = [self.root / f"{index}.png" for index in range(2)]
        for path, color in zip(self.photos, ("red", "blue")):
            Image.new("RGB", (240, 320), color).save(path)
        self.session = PlayerSession(self.photos, [], self.audio, fullscreen=True)
        self.session.animation = self.animation

    def test_top_and_bottom_show_matching_characters_without_changing_letter_or_volume(self):
        for button, name in (("up", "listening"), ("down", "speaking")):
            self.session.action(button)
            self.assertEqual(self.animation.active, name)
            self.assertEqual(self.session.gallery.index, 0)
            self.assertEqual(self.audio.volume, .2)
            with Image.open(ROOT / f"media/animations/{name}/frame-00.png") as expected:
                self.assertEqual(self.session.frame().tobytes(), expected.tobytes())

    def test_two_cycles_at_five_fps_end_on_original_letter_card(self):
        self.session.action("down")
        self.assertEqual(self.animation.index(), 0)
        key = self.session.render_key()
        self.now += .1
        self.assertEqual(self.session.render_key(), key)
        for tick in range(1, 8):
            self.now = 100 + tick / 5 + .001
            self.assertEqual(self.animation.index(), tick % 4)
        self.now = 101.601
        self.assertEqual(self.session.frame().tobytes(), Image.new("RGB", (240, 320), "red").tobytes())
        self.assertIsNone(self.animation.active)
        self.assertEqual(self.animation.payloads, [])

    def test_navigation_interrupts_animation_and_preserves_wraparound(self):
        self.session.action("up")
        self.session.action("left")
        self.assertEqual(self.session.gallery.index, 1)
        self.assertIsNone(self.animation.active)
        self.assertEqual(self.session.frame().getpixel((0, 0)), (0, 0, 255))
        self.session.action("down")
        self.session.action("right")
        self.assertEqual(self.session.gallery.index, 0)
        self.assertIsNone(self.animation.active)

    def test_other_button_switches_and_same_button_lets_the_loop_finish(self):
        self.session.action("down")
        self.now += .401
        self.assertEqual(self.animation.index(), 2)
        self.session.action("up")
        self.assertEqual(self.animation.index(), 0)
        self.assertEqual(self.animation.active, "listening")
        serial = self.animation.serial
        self.now += .601
        self.session.action("up")
        self.assertEqual(self.animation.serial, serial, "Mashing UP must not restart the running loop")
        self.assertEqual(self.animation.index(), 3)
        self.now += 5
        self.assertIsNone(self.animation.index())
        self.session.action("up")
        self.assertEqual((self.animation.serial, self.animation.index()), (serial + 1, 0))

    def test_bundled_png_raw_and_wire_frames_match_exactly(self):
        for name, frames in self.animation.clips.items():
            self.assertEqual(len(frames), 24 if name == "hemulen" else 4)
            self.animation.start(name)
            self.assertEqual(self.animation.wire_frame(),
                             (self.animation.directory / frames[0]["bin"]).read_bytes())
            for frame in frames:
                with Image.open(self.animation.directory / frame["png"]) as png:
                    self.assertEqual(png.mode, "RGB")
                    self.assertEqual(png.size, (240, 320))
                    expected = rgb565(png)
                wire = (self.animation.directory / frame["bin"]).read_bytes()
                raw = (self.animation.directory / frame["raw"]).read_bytes()
                self.assertEqual(wire, expected)
                self.assertEqual(raw[0::2], wire[1::2])
                self.assertEqual(raw[1::2], wire[0::2])

    def test_listening_feet_remain_at_one_screen_anchor_throughout_the_loop(self):
        anchors = []
        for frame in self.animation.clips["listening"]:
            with Image.open(self.animation.directory / frame["png"]) as image:
                # Foot outlines below the apron; arm and head motion do not enter this region.
                points = [(x, y) for y in range(250, 285) for x in range(75, 170)
                          if sum(image.getpixel((x, y))) < 450]
                anchors.append((min(x for x, y in points if x < 120),
                                max(y for x, y in points)))
        self.assertEqual(anchors, [(84, 266)] * 4)

    def test_hemulen_has_a_smooth_eight_second_loop_over_a_stationary_scene(self):
        settings = Settings.load()
        animation = CharacterAnimation(ROOT / 'media/animations', clock=lambda: self.now,
                                       clip_options=settings.data['animations']['clips'])
        animation.start('hemulen')
        self.assertEqual(animation.fps, 6)
        self.assertEqual(animation.duration, 8)
        self.assertEqual(len(animation.clips['hemulen']), 24)
        first = animation.frame()
        poses = []
        for index in range(24):
            self.now = 100 + index / 6 + .001
            frame = animation.frame()
            self.assertEqual(frame.crop((0, 163, 240, 320)).tobytes(),
                             first.crop((0, 163, 240, 320)).tobytes(), 'Body, hands, feet, and flower must stay fixed')
            self.assertEqual(frame.crop((193, 140, 220, 190)).tobytes(),
                             first.crop((193, 140, 220, 190)).tobytes(), 'The glass stays in its original position')
            poses.append(frame.crop((100, 40, 193, 162)).tobytes())
        self.assertEqual(len(set(poses)), 24, 'Every exported head pose must be different')
        self.assertIsNotNone(ImageChops.difference(first, animation.frame()).getbbox())
        self.now = 107.99
        self.assertIsNotNone(animation.frame())
        self.now = 108
        self.assertIsNone(animation.frame())
        animation.start('speaking')
        self.assertEqual(animation.fps, 5, 'Other clips retain their original configured timing')

    def test_rotated_wire_payload_preserves_pixel_words(self):
        animation = CharacterAnimation(ROOT / "media/animations", rotation=180)
        animation.start("speaking")
        with Image.open(ROOT / "media/animations/speaking/frame-00.png") as png:
            expected = rgb565(png.rotate(180))
        self.assertEqual(animation.wire_frame(), expected)

    def test_wire_cache_keeps_one_frame_and_reuses_it_until_the_tick_changes(self):
        self.animation.start("listening")
        with patch.object(Path, "read_bytes", autospec=True) as read:
            def load(path):
                with path.open("rb") as source:
                    return source.read()
            read.side_effect = load
            first = self.animation.wire_frame()
            self.assertIs(self.animation.wire_frame(), first)
            self.assertEqual(read.call_count, 1)
            self.now += .201
            self.animation.wire_frame()
            self.assertEqual(read.call_count, 2)
            self.assertEqual(len(self.animation.payloads), 1)
            self.assertEqual(len(self.animation.payloads[0]), 153600)

    def test_display_sends_precompiled_bytes_and_rejects_truncated_payload_before_spi(self):
        self.animation.start("speaking")
        payload = self.animation.wire_frame()
        display = ST7789.__new__(ST7789)
        from unittest.mock import Mock
        display.spi, display.dc, display.command = Mock(), Mock(), Mock()
        with patch("app.hardware.rgb565", side_effect=AssertionError("Unexpected runtime encoding")):
            display.show_rgb565(payload)
        display.spi.writebytes2.assert_called_once_with(payload)
        self.assertEqual(display.command.call_args_list[-1].args, (0x2C,))
        display.command.reset_mock()
        with self.assertRaisesRegex(ValueError, "153600"):
            display.show_rgb565(payload[:-1])
        display.command.assert_not_called()

    def test_compiler_has_known_primary_color_byte_order(self):
        source, destination = self.root / "source", self.root / "compiled"
        source.mkdir()
        for name in ("listening", "speaking"):
            Image.new("RGB", (480, 640), "red").save(source / f"{name}-atlas.png")
        spec = importlib.util.spec_from_file_location("prepare_animations", ROOT / "scripts/prepare-animations.py")
        compiler = importlib.util.module_from_spec(spec)
        spec.loader.exec_module(compiler)
        compiler.prepare(source, destination)
        self.assertEqual((destination / "speaking/frame-00.raw").read_bytes(), bytes.fromhex("00f8") * (240 * 320))
        self.assertEqual((destination / "speaking/frame-00.bin").read_bytes(), bytes.fromhex("f800") * (240 * 320))

    def test_alphabet_configuration_requires_portrait_and_hardware_fps(self):
        settings = Settings.load(ROOT / "config.json")
        self.assertTrue(settings.data["animations"]["enabled"])
        for rotation in (90, 270):
            settings.data["display"]["rotation"] = rotation
            with self.assertRaisesRegex(ValueError, "portrait"):
                settings.validate()
        settings.data["display"]["rotation"] = 0
        settings.data["animations"]["fps"] = 12
        with self.assertRaisesRegex(ValueError, "FPS"):
            settings.validate()

    def test_keyboard_loop_uses_raw_frames_and_limits_transfers_with_spi_time(self):
        settings = Settings.load(ROOT / "config.json")
        settings.data["letter_drawing"]["enabled"] = False
        settings.data["animations"]["enabled"] = True
        sent, pngs = [], []
        elapsed = [100.0]
        class Display:
            closed = False
            def show(self, frame): pngs.append(frame)
            def show_rgb565(self, payload):
                sent.append((elapsed[0], payload))
                elapsed[0] += .123  # Native full-screen transfer at 10 MHz.
            def close(self): self.closed = True
        display = Display()
        class Keyboard:
            calls = 0
            def __enter__(self): return self
            def __exit__(self, *args): pass
            def read(self):
                self.calls += 1
                return "w" if self.calls == 1 else "q" if elapsed[0] > 106 else ""
        def make_animation(*args, **kwargs):
            return CharacterAnimation(*args, clock=lambda: elapsed[0], **kwargs)
        def sleep(seconds): elapsed[0] += seconds
        with patch("app.app.prepare_images", return_value=self.photos), patch("app.app.display_resource", side_effect=lambda stack, *args: (stack.callback(display.close), display)[1]), patch("app.app.CharacterAnimation", side_effect=make_animation), patch("app.app.Keyboard", Keyboard), patch("app.app.time.monotonic", side_effect=lambda: elapsed[0]), patch("app.app.time.sleep", side_effect=sleep):
            run_gallery(settings, simulate=True, no_audio=True)
        self.assertTrue(display.closed)
        self.assertGreaterEqual(len(sent), 4)
        self.assertTrue(all(b[0] - a[0] >= .2 for a, b in zip(sent, sent[1:])))
        self.assertGreaterEqual(len(pngs), 2, "Initial and restored letter cards must reach the display")
        self.assertEqual(pngs[-1].tobytes(), pngs[0].tobytes())
        self.assertEqual(sent[0][1], (ROOT / "media/animations/listening/frame-00.bin").read_bytes())


if __name__ == "__main__":
    unittest.main()
