hvitis/Alfa/(commit log)

2026-10-16 Update 'A little look around' with hardware connections, inside back case, and roentgen renders
2026-10-17 feat: show stl preview, estimation price tables
2026-10-18 fix: make wire frame freshness check compare file modification times
2026-10-18 fix: use prebuilt plywood assembly guide PDF in CI when CAD previews are omitted
2026-10-18 fix(web): fix wiring diagram dimensions, remove explore label, toggle teaching ADR, and single card image
2026-10-18 feat: update case design
2026-10-18 feat: update the 3d print preview
2026-10-19 relocate battery
2026-10-23 perf(ci): accelerate workflows and add case renders and downloadables
    - Streamline .github/workflows/ci.yml, pcb.yml, and release.yml:
    - Remove blocking multi-GB KiCad container downloads on every commit
    - Track verified KiCad export artifacts in design/pi3-shield/generated/
    - Add Playwright browser caching (~/.cache/ms-playwright)
    - Remove redundant apt-get ffmpeg installations
    - Upgrade GitHub actions to stable @v4 / Pages @v3/@v4
    - Add 3D-printed cloud radio renders showcase (assembled, inside back case, x-ray, exploded, rear, side profile)
    - Add wooden plywood case renders and blueprint gallery (enclosure, internals, exploded, 1:1 A4 sheets)
    - Add download packages and assets: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
2026-10-23 fix(ci): restore ffmpeg from a static build instead of apt
    The previous commit dropped the apt ffmpeg install, so the audio
    preparation test failed with "ffmpeg is missing". The apt install it
    replaced had stalled for 10+ minutes on the azure.archive.ubuntu.com
    mirror, so fetch static ffmpeg/ffprobe from GitHub releases and cache
    them instead.
